ondfrukt/Phone-exchange/README.md

# Phone Exchange - (Under development) # 

## Thanks to! ##

First of all, I want to thank my partner Amanda, who has been som patiant whit me - spending countless hours and weekends by my computer while I, for example, trying to figure out a way to capture pulses from rotary phones, or comforting during mental breakdowns when I was sodering without realizing I was using to low temperatur. If you are reading this - which you might not, since you're probebly so tierd of this project - I just want to say that i love you, and do that even more for standing out with me and my stupid phones.

I would also like to thank two GitHub members from whom I’ve drawn a lot of inspiration.

1. [GadgetReboot](https://github.com/GadgetReboot) with his YouTube videos and repositories about the KS0835F SLIC module and the MT8816 switch matrix, really made this project possible.

3. [Ktownsen](https://github.com/ktownsend-personal/) and his repository [RetroPhone](https://github.com/ktownsend-personal/RetroPhone) showed me that there is someone else out there who thinks an old wired phone network would be cool, and who shares the same passion for making vintage phones work just like they did back in the day. My call process modes and flows are heavily inspired by his work.

## Goal whit the project ##
The project aims to create a local wired phone network that supports both old rotary phones and newer DTMF tone-dialing phones. No intelligence or electronics will be built into the phones themselves; all logic and switching will be handled by the exchange unit. The network will follow a star topology, with two wires leading to each phone.

The goal is for the network to behave just like it did back in the day. Features such as ringing behavior, tones, and call logic will be implemented.

This is a learning project and my personal introduction to programming, Arduino, HTML, and electronics. It might eventually result in nothing more than a pile of electronic scrap and hundreds of non-functional lines of code—but it will definitely provide me with valuable knowledge and a steep learning curve.

### Typical behaviour for all call ###

A typical procedure of the system will be as shown below.
- A hook is lifted, the status of the line changes from "idle" to "ready" and a continuous tone can be heard in the phone hook.
- A phone number is dialed using pulse dialing or DTMF tones, and the digits are captured by the microcontroller.
- Ring pulses are generated to the dialed line and once the hook is picked up, the audio lines are connected between the two lines and the conversation can begin.
- Ones one of the connected phones puts it's handset into the crank, the audio connection between the lines breaks and the call ends.

## Hardware ##
<p align="center">
System Overview
</p>

| Component | Description |
|---|---|
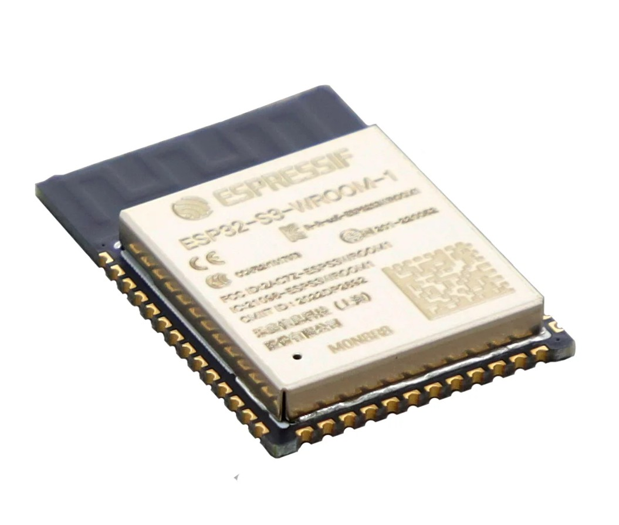
[picture p1: docs/ESP32-S3-WROOM.jpg]
| ESP32-S3<br>  | - I have always appreciated the ESP family of microcontrollers. After first experimenting with Arduino modules such as the Arduino Uno and Arduino Uno WiFi, it quickly became clear that the ESP32 offered significantly more features at a lower cost. <br> - This module includes 8 MB of flash memory — an important improvement, since the 4 MB version ran out of space during earlier POC work. <br> - Like most ESP chips, it also provides both WiFi and Bluetooth, which are used here for the webserver and WiFi provisioning. The ESP32-C6 was initially considered due to its support for Matter and Zigbee. However, at the time it was not supported in PlatformIO, so the more common ESP32-S3 was selected for this project.
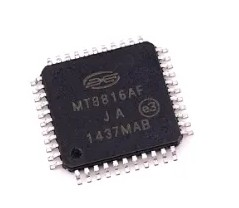
[picture p2: docs/MT8816AF.jpg]
| MT8816<br> | The MT8816 is a crosspoint swich matrix where you can connect one phone lines audio out to a certain lines audio in, and of course also in the opposite direction so a full audio connection is established more about how it works can be found [here](src/services/Readme.md) | 
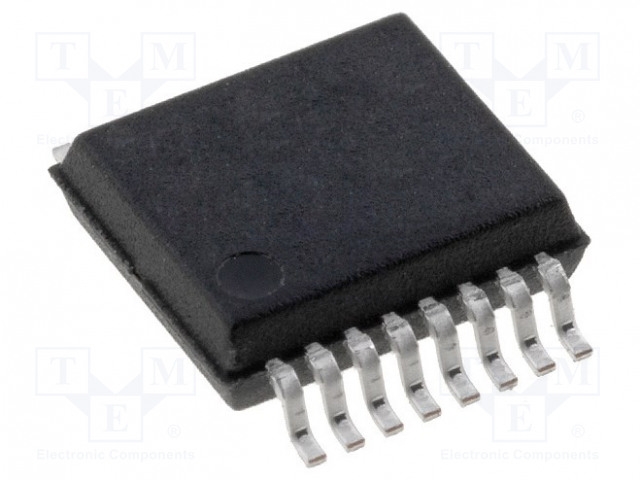
[picture p3: docs/MT8870.jpg]
| MT8870<br> | This circuit translates all tones from DTMF phones into digits. |
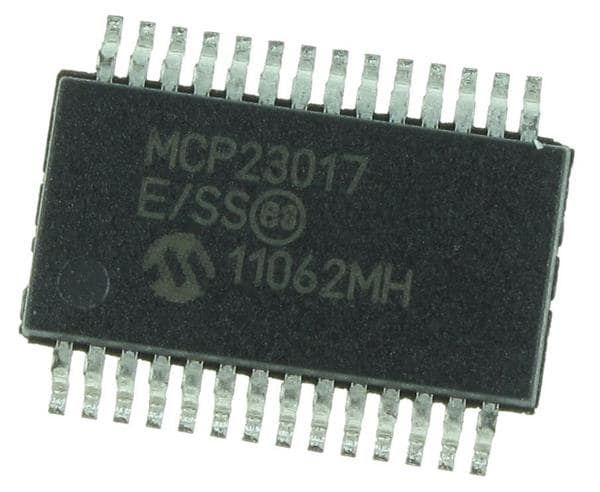
[picture p4: docs/MCP23017.jpg]
| MCP23017 | GPIO expanders because the ESP32 do not have enough GPIO ports to control all devices |
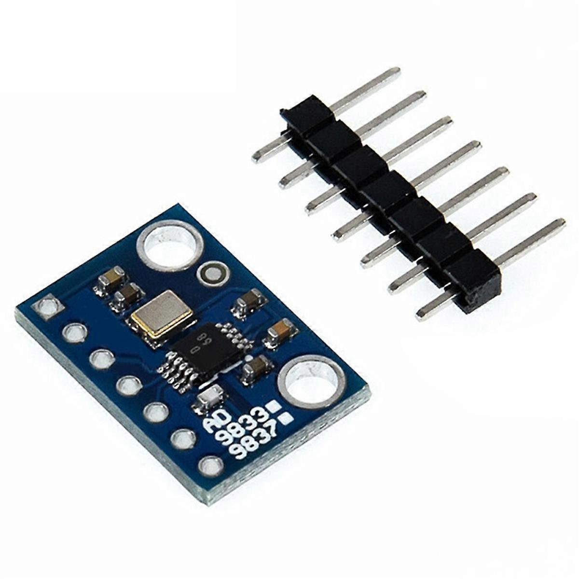
[picture p5: docs/AD9833.jpg]
| AD9833 module | The AD9833 module, which I have three of in the exchange Is sending out tones into the swich matrix and then thuther to lines. |
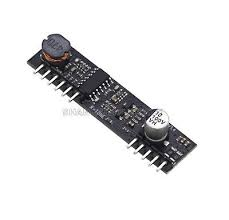
[picture p6: docs/KS0835F.jpg]
| KS0835F<br> | This module may be the most important one on the breadboard. It handles the phone's behavior and converts it into signals that my ESP can process. It detects whether the phone's hook is on or off and can generate a ring frequency, which would otherwise be very complicated to produce. |
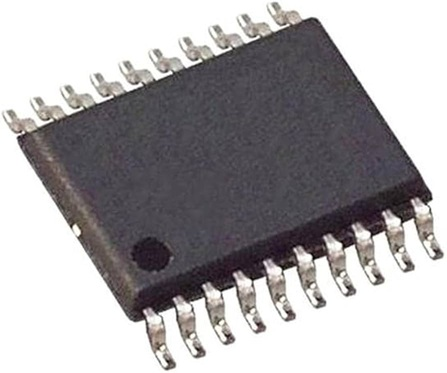
[picture p7: docs/PCM5102.jpg]
| PCM5102<br> | Audio files stored on the ESP are sent to this digital-to-analog converter to output audio messages to the lines when needed. The converter uses I²S communication with the ESP and outputs an analog representation of short, pre-stored audio clips. |
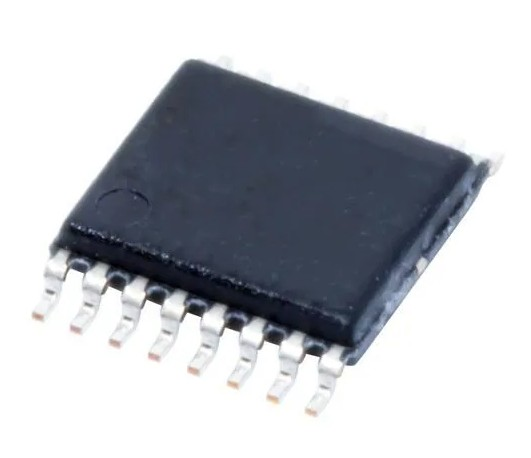
[picture p8: docs/TMUX4051.jpg]
| TMUX4051<br> | This audio multiplexer acts like a large switch, allowing the audio-out channel of each line to be selectively connected to the MT8870 DTMF detector. Only one channel at a time is connected to the DTMF decoder, and the system continuously sweeps through all lines that are in a state where tone detection is required.

In this way, it is possible to determine which line a tone originates from while using only a single DTMF detector.  |

## Webserver ##
I thought it would be good to have an interface where you could manage the phone system in some way, such as assigning a phone number to a specific line, activating/deactivating lines, changing the ring tone length, and adding some more features. During operation, access to the serial monitor will be limited, so having a way to easily tweak settings and access some debugging information would be useful.

The webserver can be reached at http://phoneexchange.local/ after the provisioning is completed

## MQTT ##
Having an MQTT function is also a goal so that the server can potentially interact with a smart home system such as Home Assistant, opening up the possibility to control home functions — just for fun!

## Line Statuses ##

To handle the logics in the exchange system, all lines has a current status whish triggers different logics in the system when they are changed.

### Status table ###
- Hook  :telephone_receiver: - If the phone hook is on or off due to the status
- Timer :stopwatch: - If the new status initiate a timer
- Audio :loud_sound: -  If a audio is played to the line due to the status (might not be implemented)
- Tone :postal_horn: - if a tone is played to the line due to the status

| Phone status  | Function | Hook | Timer | Audio | Tone |
| --- | --- | --- | ----- |---|---|
| idle | Line is not in use | ✅ ON | ❌ | ➖ | ❌ |
| ready | Line is ready, waiting for inputs | ⚪ OFF | ✅ | ➖ | ✅ |
| puls_dialing  | Rotary dialing in progress | ⚪ OFF | ✅ | ➖ | ❌ |
| tone_dialing  | Touch-tone dialing in progress | ⚪ OFF | ✅ | ➖ | ❌ |
| busy | Receiving busy signal | ⚪ OFF | ✅ | ➖ | ✅ |
| fail | Line failed to connect | ⚪ OFF | ✅ | ➖ | ✅ |
| ringing | Line is ringing (outgoing call) | ⚪ OFF | ✅ | ➖ | ✅ |
| connected | Call is active | ⚪ OFF | ❌ | ➖ | ❌ |
| disconnected  | Call has ended, but line not yet idle | ⚪ OFF | ✅ | ➖ | ❌ |
| timeout | Line timed out | ⚪ OFF | ✅ | ➖ | ✅ |
| abandoned | Line was abandoned | ⚪ OFF | ✅ | ➖ | ✅ |
| incoming | Incoming call | ✅ ON | ❌ | ➖ | ❌ |
| operator | Connected to operator | ➖ | ❌ | ➖ | ❌ |

### Status flow chart ###
The flowchart below shows how the statuses change based on the behavior of the phone hooks or when status timers expire. This part is largely inspired by [GadgetReboot](https://github.com/GadgetReboot)
 and his repository “Retro Phone”. Many thanks to him!
 
  <a href="https://raw.githubusercontent.com/ondfrukt/phone-exchange/main/docs/StatusflowChart.drawio.svg">
    Diagram (SVG)
  </a>

## Challenges ##

- **SHK interference during ring signal generation**

The KS0835F SLIC's ring voltage (RM HIGH, FR toggling at 20 Hz) induces false SHK transitions, making it impossible to distinguish interference from a real pick-up. Simply ignoring SHK events during ringing suppresses the noise but also swallows genuine pick-ups — the interrupt is consumed and no new one fires during the pause, so the call never connects.

**Workaround in `SHKService`:** SHK events during `RingToggling` are still suppressed. When a line transitions from `RingToggling` to `RingPause`, the SHK pin is immediately force-polled. The debounce filter then confirms the true state: a real pick-up keeps SHK HIGH and the call connects; interference has already cleared and no change is registered. Maximum detection delay equals one ring-burst length (default 1 s).
