ondfrukt/Phone-exchange/src/util/Readme.md

Här läggs små funktioner som används enstaka tillfälle vid exempelvis uppstart. i2C-scanner exempelvis eller uppstartsmeddelanden.
