ondfrukt/Phone-exchange/docs/Block Diagram Hardware.drawio.png

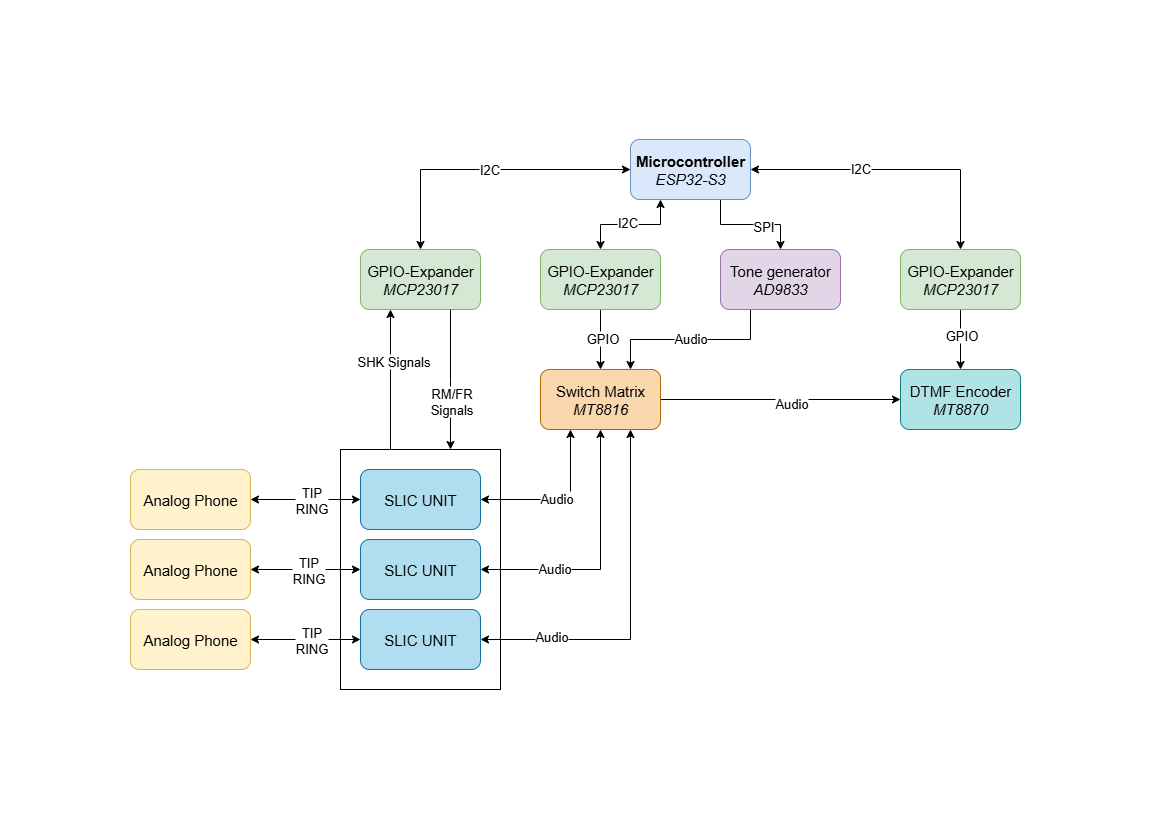
docs/Block Diagram Hardware.drawio.png
