ondfrukt/Phone-exchange/docs/MT8816 Connections.png

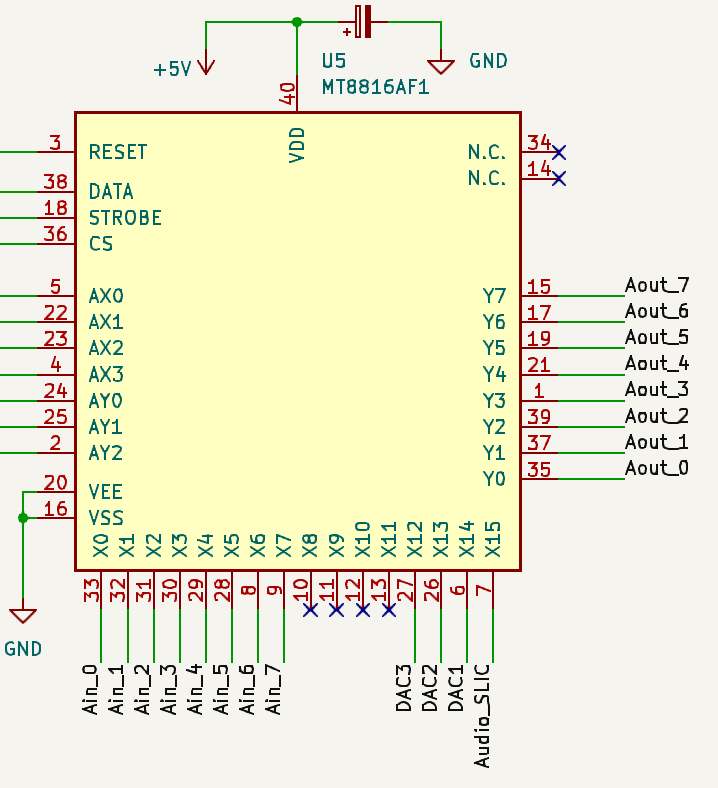
docs/MT8816 Connections.png
