ondfrukt/Phone-exchange/docs/MT8817.jpg

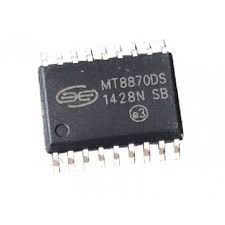
docs/MT8817.jpg
