ondfrukt/Phone-exchange/(threads)

Thread 7 (2025-09-07):

More documentation

QuteNZ, 2025-09-07:
Great to see a phone exchange project and I do like to build one for fun as desktop phones may disappeared because of the prefoliation of mobile device.

A schematics or detailed documentation in PDF format would be great for me to get it started.

Thank you for your generosity for your contribution.

cheers,
Yubing Zhang

ondfrukt, 2025-09-10:
Wow! Never thought that this would be of interest for anyone!
I have kind of worked with this for a long time but speeded the tempo last months to get somewhere. At the moment I'm waiting for my second PCB that will holds all my slic-modules and also finishing sodering my first PCB which holds my ESP and other functions.

Ass soon I have verified that it all works like I hope -  I will upload all schematics and further describe it!
