ondfrukt/Phone-exchange/KiCad/Exchange SLIC-unit V1.3/Exchange SLIC-unit.kicad_pcb

## KiCad design KiCad/Exchange SLIC-unit V1.3/Exchange SLIC-unit.kicad_pcb (2026-10-24)

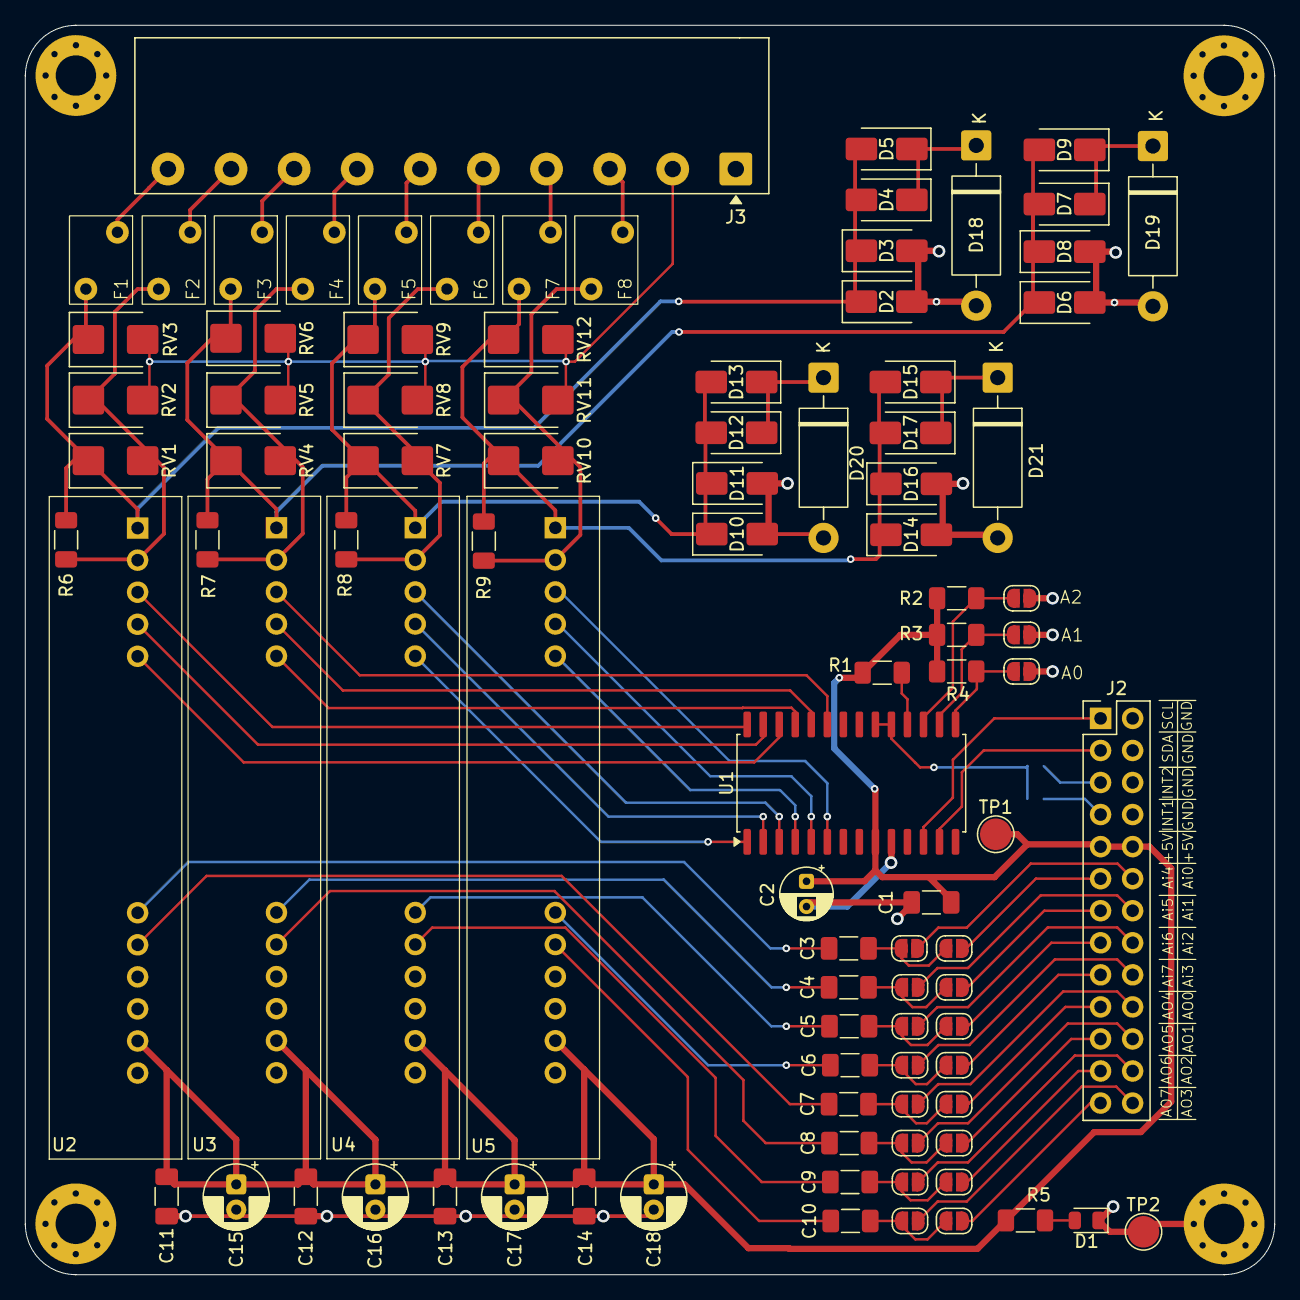
[picture p12: board Exchange SLIC-unit.kicad_pcb from above]

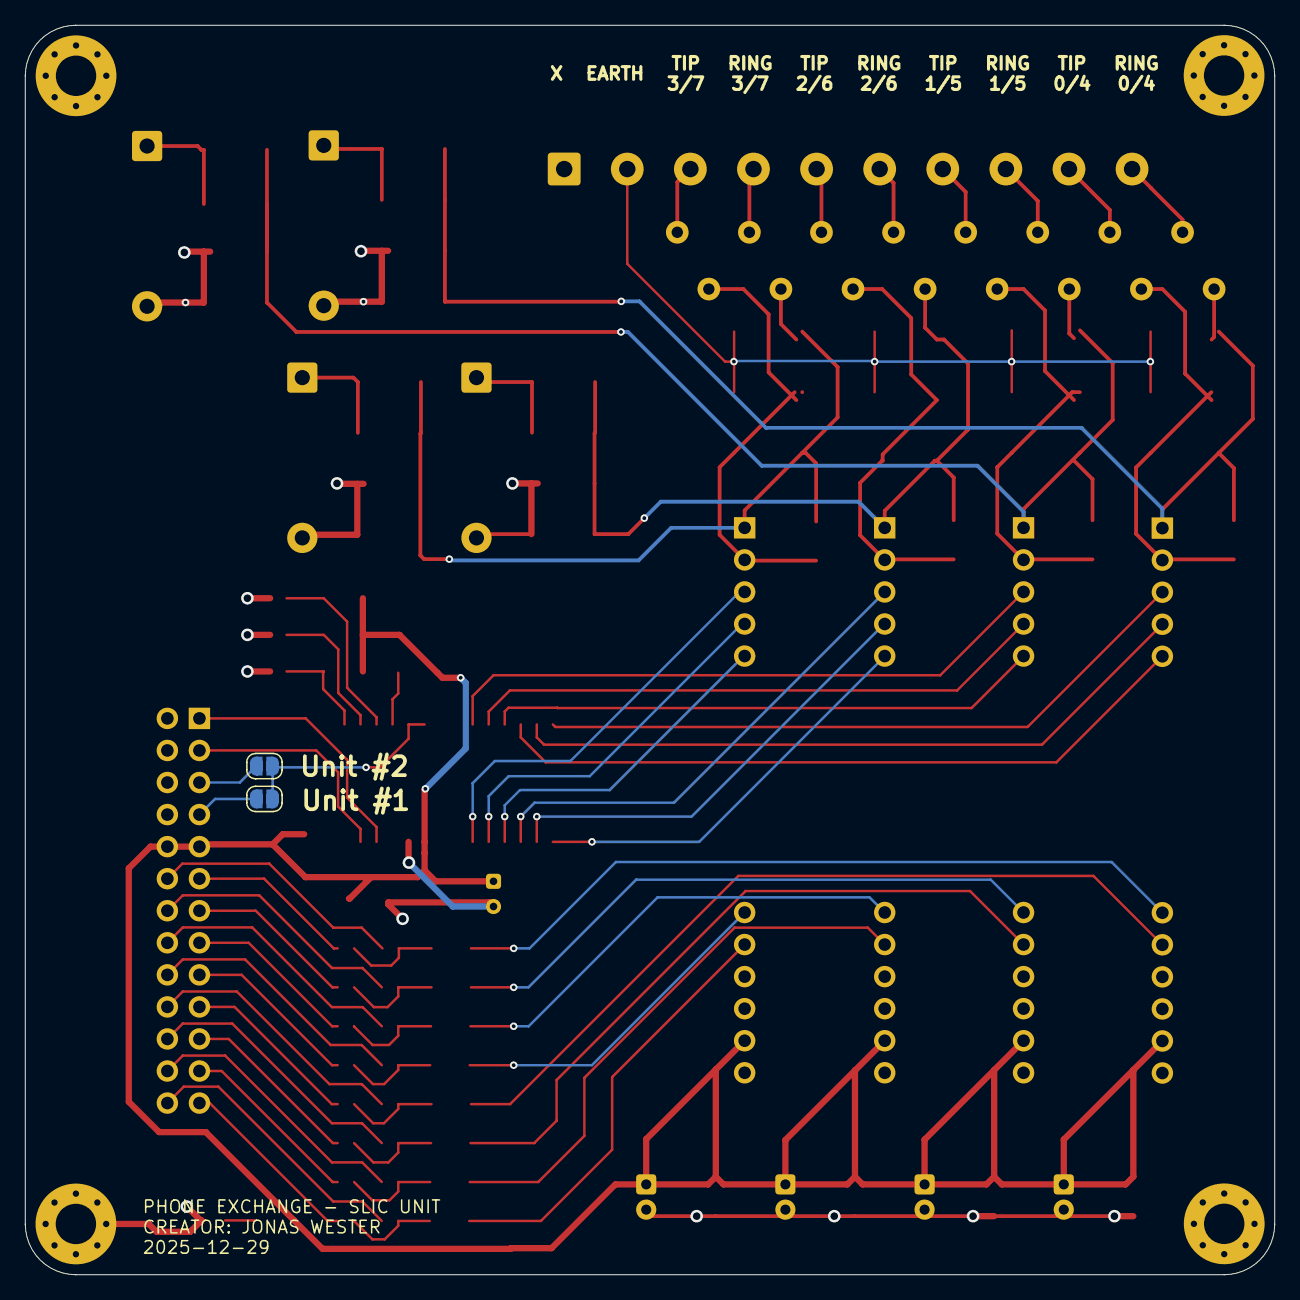
[picture p13: board Exchange SLIC-unit.kicad_pcb from below]

Board: 4 copper layers, 99.0 x 99.0 mm, 102 parts (2 on the bottom side), 77 nets.

Parts:
C1, C3, C4, C5, C6, C7, C8, C9, C10, C11, C12, C13, C14: 0.1uF; C_1206_3216Metric_Pad1.33x1.80mm_HandSolder
C2: 10uF; CP_Radial_D4.0mm_P2.00mm
C15, C16, C17, C18: 10uF; CP_Radial_D5.0mm_P2.00mm
D1: POWER LED; LED_0805_2012Metric
D2, D3, D4, D5, D6, D7, D8, D9, D10, D11, D12, D13, D14, D15, D16, D17: SM4004; D_SMA
D18, D19, D20, D21: P6KE51A; D_DO-15_P12.70mm_Horizontal
F1, F2, F3, F4, F5, F6, F7, F8: MF-R025; Fuse_Polyfuse_BK250_5.08mm_P0.8D1.8
H1, H2, H3, H4: MountingHole_Pad; MountingHole_3.2mm_M3_Pad_Via
J2: Conn_02x13_Odd_Even; PinHeader_2x13_P2.54mm_Vertical
J3: Screw_Terminal_01x10; TerminalBlock_Phoenix_MKDS-1,5-10_1x10_P5.00mm_Horizontal -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
JP1, JP2, JP3, JP4, JP5, JP6, JP7, JP8, JP9, JP10, JP11, JP12, JP13, JP14, JP15, JP16, JP17, JP18, JP19, JP20, JP21: SolderJumper_2_Open; SolderJumper-2_P1.3mm_Open_RoundedPad1.0x1.5mm
R1, R2, R3, R4: 10k; R_1206_3216Metric_Pad1.30x1.75mm_HandSolder
R5: 1k; R_1206_3216Metric_Pad1.30x1.75mm_HandSolder
R6, R7, R8, R9: 1M; R_1206_3216Metric_Pad1.30x1.75mm_HandSolder
RV1, RV2, RV3, RV4, RV5, RV6, RV7, RV8, RV9, RV10, RV11, RV12: Varistor; D_SMB
TP1, TP2: TestPoint; TestPoint_Pad_D2.5mm
U1: MCP23017; SOIC-28W_7.5x17.9mm_P1.27mm
U2, U3, U4, U5: KS0835F

Connections:
+5V: C1.2, C2.1, C11.1, C12.1, C13.1, C14.1, C15.1, C16.1, C17.1, C18.1, J2.9, J2.10, R1.1, R2.1, R3.1, R4.1, R5.1, TP1.1, U1.9 (VDD), U2.10 (+VDC), U3.10 (+VDC), U4.10 (+VDC), U5.10 (+VDC)
/Ain_0/4: C3.2, JP1.1 (A), JP9.2 (B)
/Ain_1/5: C4.2, JP2.1 (A), JP10.2 (B)
/Ain_2/6: C5.2, JP3.1 (A), JP11.2 (B)
/Ain_3/7: C6.2, JP4.1 (A), JP12.2 (B)
/Aout_0/4: C7.2, JP5.1 (A), JP13.2 (B)
/Aout_1/5: C8.2, JP6.1 (A), JP14.2 (B)
/Aout_2/6: C9.2, JP7.1 (A), JP15.2 (B)
/Aout_3/7: C10.2, JP8.1 (A), JP16.2 (B)
/FR_0/4: U1.28 (GPA7), U2.3 (F/R)
/FR_1/5: U1.23 (GPA2), U3.3 (F/R)
/FR_2/6: U1.3 (GPB2), U4.3 (F/R)
/FR_3/7: U1.6 (GPB5), U5.3 (F/R)
/MCP_SLIC_INT_1/2: JP17.1 (A), JP18.1 (A), U1.19 (INTB), U1.20 (INTA)
/RING_0/4: F1.2, J3.10
/RING_1/5: F3.2, J3.8
/RING_2/6: F5.2, J3.6
/RING_3/7: F7.2, J3.4
/RM_0/4: U1.27 (GPA6), U2.4 (RM)
/RM_1/5: U1.24 (GPA3), U3.4 (RM)
/RM_2/6: U1.2 (GPB1), U4.4 (RM)
/RM_3/7: U1.5 (GPB4), U5.4 (RM)
/SCL: J2.1, U1.12 (SCL)
/SDA: J2.3, U1.13 (SDA)
/SHK_0/4: U1.26 (GPA5), U2.5 (SHK)
/SHK_1/5: U1.25 (GPA4), U3.5 (SHK)
/SHK_2/6: U1.1 (GPB0), U4.5 (SHK)
/SHK_3/7: U1.4 (GPB3), U5.5 (SHK)
/TIP_0/4: F2.2, J3.9
/TIP_1/5: F4.2, J3.7
/TIP_2/6: F6.2, J3.5
/TIP_3/7: F8.2, J3.3
GND: C1.1, C2.2, C11.2, C12.2, C13.2, C14.2, C15.2, C16.2, C17.2, C18.2, D1.1 (K), D2.2 (A), D3.2 (A), D6.2 (A), D8.2 (A), D10.2 (A), D11.2 (A), D14.2 (A), D16.2 (A), D18.2, D19.2, D20.2, D21.2, H1.1, H2.1, H3.1, H4.1, J2.2, J2.4, J2.6, J2.8, JP19.2 (B), JP20.1 (A), JP21.1 (A), TP2.1, U1.10 (VSS), U2.9 (GND), U3.9 (GND), U4.9 (GND), U5.9 (GND)
GNDPWR: J3.2, RV2.2, RV3.2, RV5.2, RV6.2, RV8.2, RV9.2, RV11.2, RV12.2
unnamed: D1.2 (A), R5.2
unnamed: D2.1 (K), D3.1 (K), D4.2 (A), D5.2 (A), F1.1, R6.1, RV1.1, RV3.1, U2.1 (RING)
unnamed: D4.1 (K), D5.1 (K), D18.1
unnamed: D6.1 (K), D7.2 (A), D8.1 (K), D9.2 (A), F3.1, R7.1, RV4.1, RV6.1, U3.1 (RING)
unnamed: D7.1 (K), D9.1 (K), D19.1
unnamed: D10.1 (K), D11.1 (K), D12.2 (A), D13.2 (A), F5.1, R8.1, RV7.1, RV9.1, U4.1 (RING)
unnamed: D12.1 (K), D13.1 (K), D20.1
unnamed: D14.1 (K), D15.2 (A), D16.1 (K), D17.2 (A), F7.1, R9.1, RV10.1, RV12.1, U5.1 (RING)
unnamed: D15.1 (K), D17.1 (K), D21.1
unnamed: J2.5, JP18.2 (B)
unnamed: J2.7, JP17.2 (B)
unnamed: J2.11, JP9.1 (A)
unnamed: J2.12, JP1.2 (B)
unnamed: J2.13, JP10.1 (A)
unnamed: J2.14, JP2.2 (B)
unnamed: J2.15, JP11.1 (A)
unnamed: J2.16, JP3.2 (B)
unnamed: J2.17, JP12.1 (A)
unnamed: J2.18, JP4.2 (B)
unnamed: J2.19, JP13.1 (A)
unnamed: J2.20, JP5.2 (B)
unnamed: J2.21, JP14.1 (A)
unnamed: J2.22, JP6.2 (B)
unnamed: J2.23, JP15.1 (A)
unnamed: J2.24, JP7.2 (B)
unnamed: J2.25, JP16.1 (A)
unnamed: J2.26, JP8.2 (B)
unnamed: JP19.1 (A), R2.2, U1.17 (A2)
unnamed: JP20.2 (B), R3.2, U1.16 (A1)
unnamed: JP21.2 (B), R4.2, U1.15 (A0)
unnamed: R1.2, U1.18 (~RESET)
unnamed: C3.1, U2.6 (Audio_in)
unnamed: C7.1, U2.7 (Audio_out)
unnamed: F2.1, R6.2, RV1.2, RV2.1, U2.2 (TIP)
unnamed: C4.1, U3.6 (Audio_in)
unnamed: C8.1, U3.7 (Audio_out)
unnamed: F4.1, R7.2, RV4.2, RV5.1, U3.2 (TIP)
unnamed: C5.1, U4.6 (Audio_in)
unnamed: C9.1, U4.7 (Audio_out)
unnamed: F6.1, R8.2, RV7.2, RV8.1, U4.2 (TIP)
unnamed: C6.1, U5.6 (Audio_in)
unnamed: C10.1, U5.7 (Audio_out)
unnamed: F8.1, R9.2, RV10.2, RV11.1, U5.2 (TIP)
