ondfrukt/Phone-exchange/KiCad/Exchange ESP-unit S3 V1.4/Exchange ESP-unit S3.kicad_pcb

## KiCad design KiCad/Exchange ESP-unit S3 V1.4/Exchange ESP-unit S3.kicad_pcb (2026-10-24)

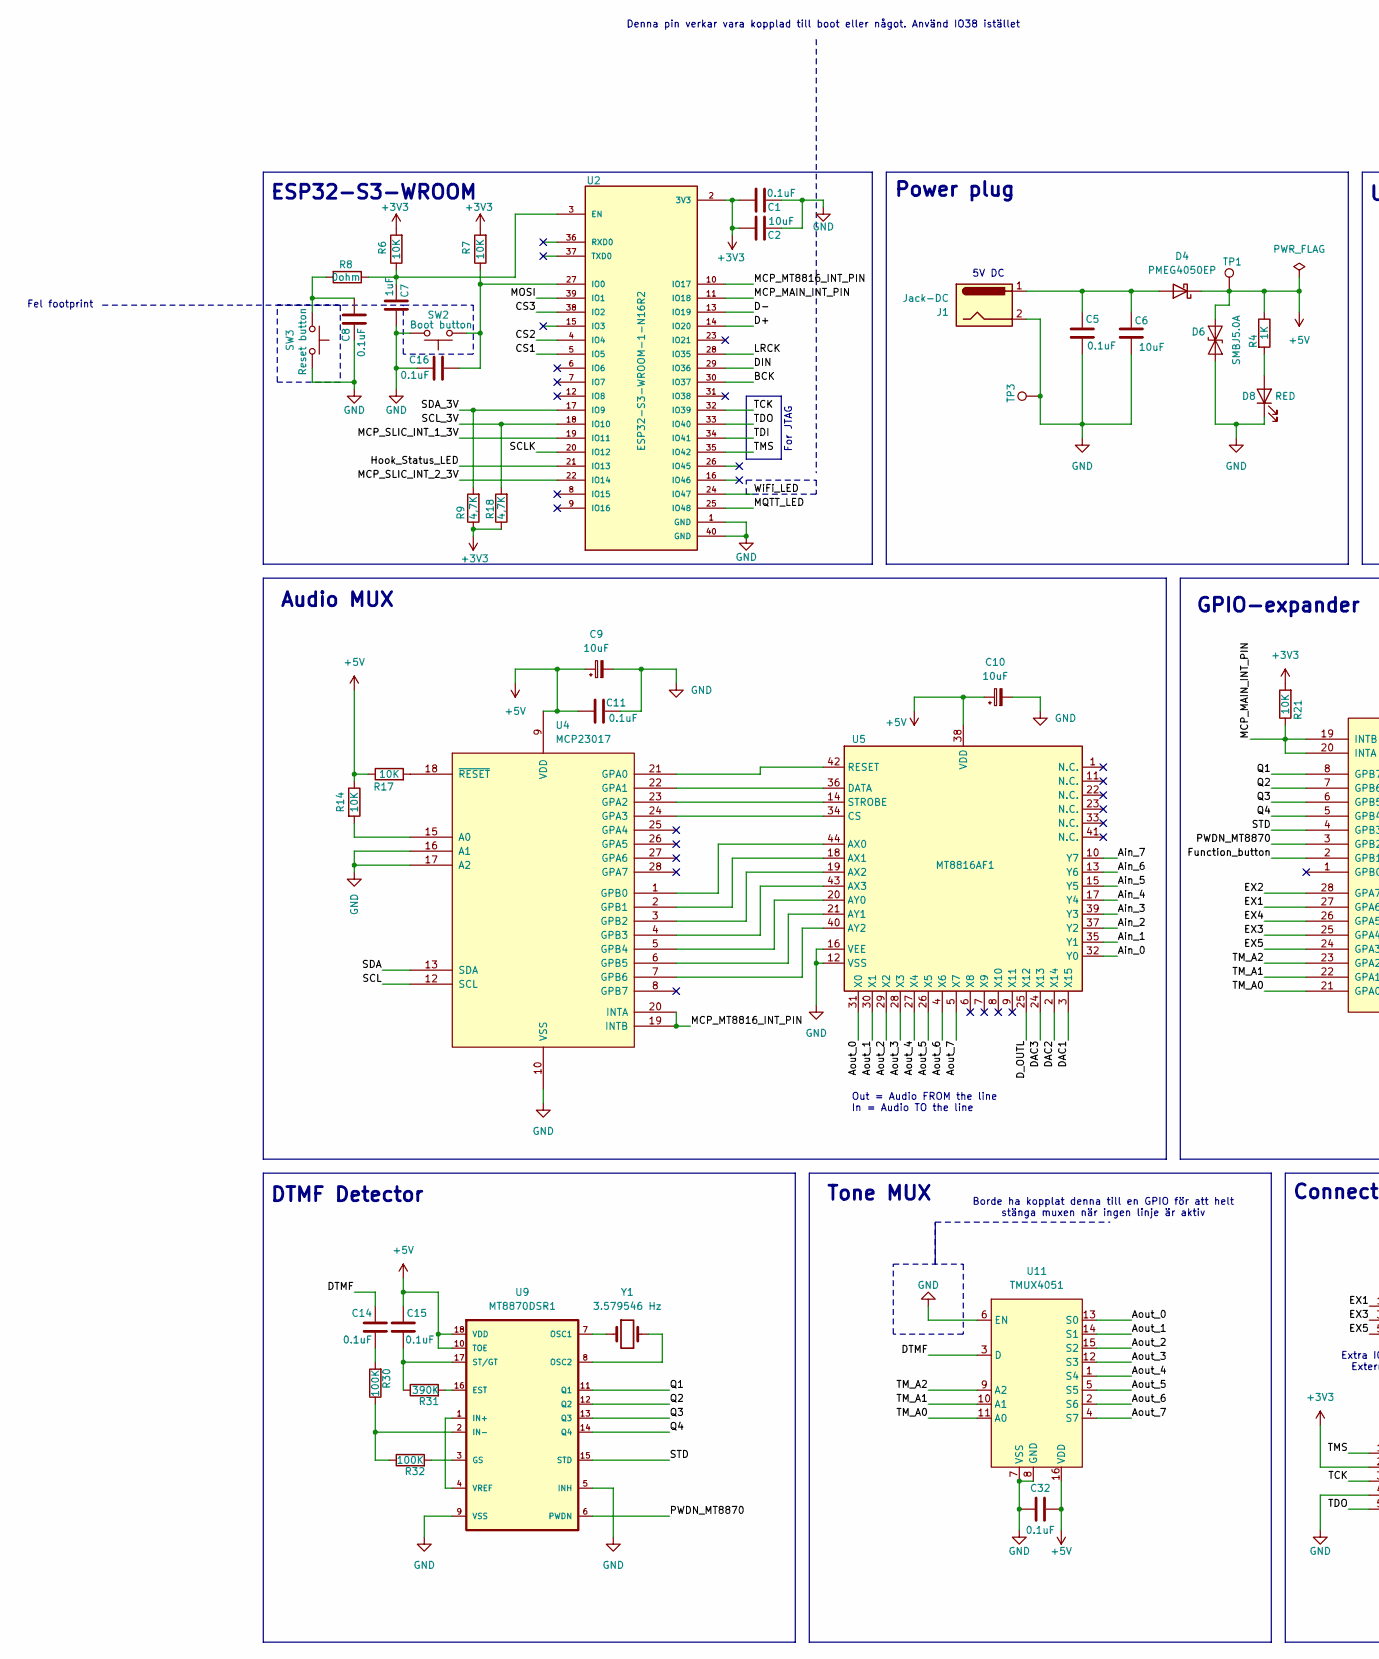
[picture p14: schematic Exchange ESP-unit S3.kicad_sch, Phone exchange - ESP-Unit, part in row 1, column 1]

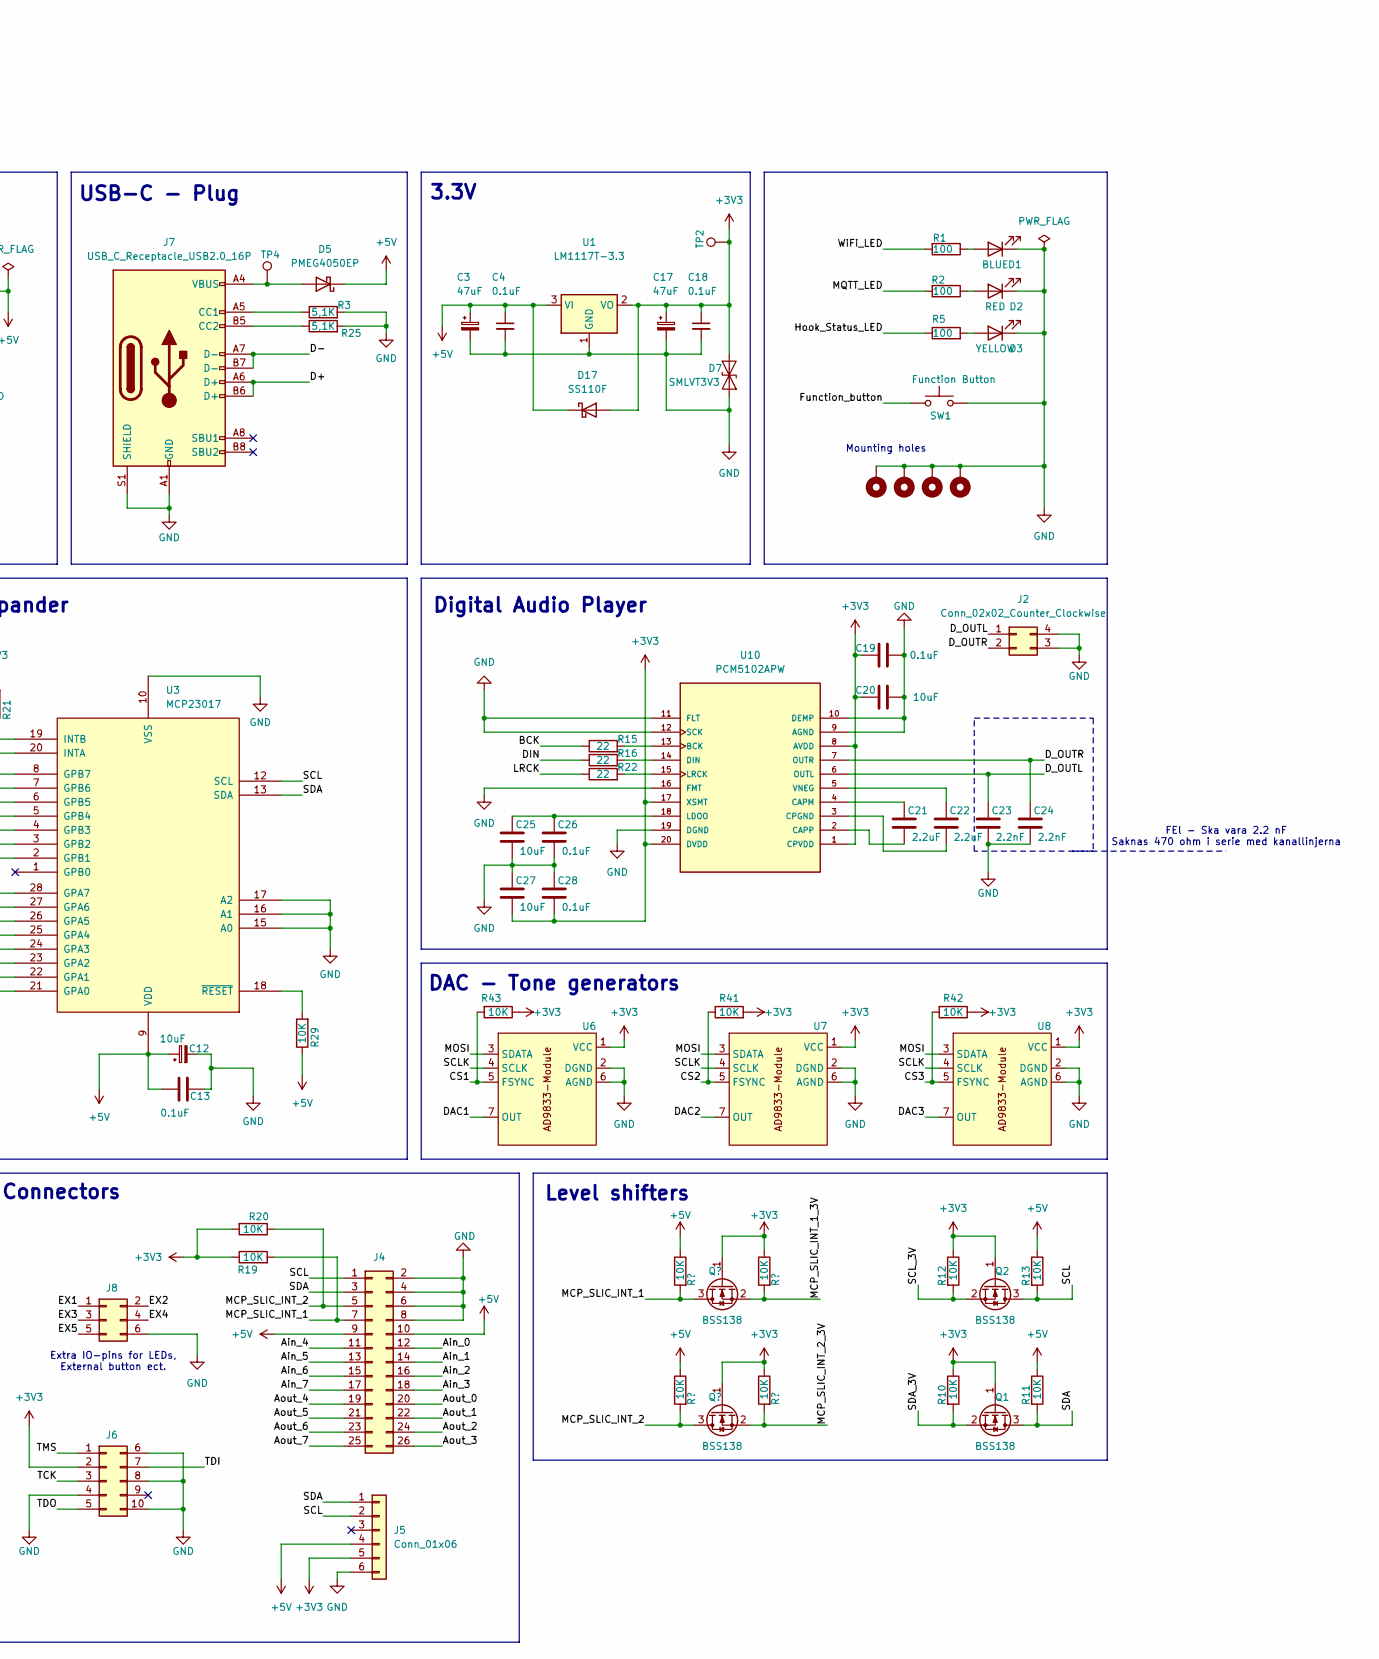
[picture p15: schematic Exchange ESP-unit S3.kicad_sch, Phone exchange - ESP-Unit, part in row 1, column 2]

Parts:
C1, C4, C5, C8, C11, C13, C14, C15, C16, C18, C19, C26, C28, C32: 0.1uF; C_1206_3216Metric_Pad1.33x1.80mm_HandSolder
C2, C6, C20, C25, C27: 10uF; C_1206_3216Metric_Pad1.33x1.80mm_HandSolder
C3, C17: 47uF; CP_Radial_D4.0mm_P2.00mm
C7: 1uF; C_1206_3216Metric_Pad1.33x1.80mm_HandSolder
C9, C10, C12: 10uF; CP_Radial_D4.0mm_P2.00mm
C21, C22: 2.2uF; C_1206_3216Metric_Pad1.33x1.80mm_HandSolder
C23, C24: 2.2nF; C_1206_3216Metric_Pad1.33x1.80mm_HandSolder
D1: BLUE; LED_0805_2012Metric_Pad1.15x1.40mm_HandSolder
D2, D8: RED; LED_0805_2012Metric_Pad1.15x1.40mm_HandSolder
D3: YELLOW; LED_0805_2012Metric_Pad1.15x1.40mm_HandSolder
D4, D5: PMEG4050EP; D_SOD-128
D6: SMBJ5.0A; D_SMB
D7: SMLVT3V3; D_SMB_Handsoldering
D17: SS110F; D_SMA_Handsoldering
H1, H2, H3, H4: MountingHole_Pad; MountingHole_3.2mm_M3_Pad_Via
J1: Jack-DC; BarrelJack_Horizontal
J2: Conn_02x02_Counter_Clockwise; PinHeader_2x02_P2.54mm_Vertical
J4: Conn_02x13_Odd_Even; PinSocket_2x13_P2.54mm_Vertical
J5: Conn_01x06; PinHeader_1x06_P2.54mm_Vertical
J6: Conn_02x05_Top_Bottom; PinSocket_2x05_P2.54mm_Vertical
J7: USB_C_Receptacle_USB2.0_16P; USB_C_Receptacle_GCT_USB4105-xx-A_16P_TopMnt_Horizontal
J8: Conn_02x03_Odd_Even; PinHeader_2x03_P2.54mm_Vertical
Q1, Q2: BSS138; SOT-23
R1, R2, R5: 100; R_1206_3216Metric_Pad1.30x1.75mm_HandSolder
R3, R25: 5,1K; R_1206_3216Metric_Pad1.30x1.75mm_HandSolder
R4: 1K; R_1206_3216Metric_Pad1.30x1.75mm_HandSolder
R6, R7, R10, R11, R12, R13, R14, R17, R19, R20, R21, R29, R41, R42, R43: 10K; R_1206_3216Metric_Pad1.30x1.75mm_HandSolder
R8: 0ohm; R_1206_3216Metric_Pad1.30x1.75mm_HandSolder
R9, R18: 4,7K; R_1206_3216Metric_Pad1.30x1.75mm_HandSolder
R15, R16, R22: 22; R_1206_3216Metric_Pad1.30x1.75mm_HandSolder
R30, R32: 100K; R_1206_3216Metric_Pad1.30x1.75mm_HandSolder
R31: 390K; R_1206_3216Metric_Pad1.30x1.75mm_HandSolder
SW1: Function Button; SW_SPST_TL3305B
SW2: Boot button; SW_SPST_TL3305B
SW3: Reset button; SW_SPST_TL3305B
TP1, TP2, TP3, TP4: TestPoint; TestPoint_Pad_D2.0mm
U1: LM1117T-3.3; TO-220-3_Vertical
U2: ESP32-S3-WROOM-1-N16R2; XCVR_ESP32-S3-WROOM-1-N16; PARTREV v1.0
U3, U4: MCP23017; SOIC-28W_7.5x17.9mm_P1.27mm
U5: MT8816AF1; TQFP-44_10x10mm_P0.8mm
U6, U7, U8: AD9833-module; AD9833-Module
U9: MT8870DSR1; SOIC-18W_7.5x11.6mm_P1.27mm
U10: PCM5102APW; TSSOP-20_4.4x6.5mm_P0.65mm; PARTREV C
U11: TMUX4051; TSSOP-16_4.4x5mm_P0.65mm
Y1: 3.579546 Hz; Crystal_HC49-4H_Vertical

Connections:
+5V: C3.1, C4.1, C9.1, C10.1, C11.1, C12.1, C13.2, C15.1, C32.2, D4.1 (K), D5.1 (K), D6.1 (A1), D17.1 (K), J4.9, J4.10, J5.4, R4.1, R11.1, R13.1, R14.1, R17.1, R29.1, TP1.1, U1.3 (VI), U3.9 (VDD), U4.9 (VDD), U5.38 (VDD), U9.10 (TOE), U9.18 (VDD), U11.16 (VDD)
/Ain_0: J4.12, U5.32 (Y0)
/Ain_1: J4.14, U5.35 (Y1)
/Ain_2: J4.16, U5.37 (Y2)
/Ain_3: J4.18, U5.39 (Y3)
/Ain_4: J4.11, U5.17 (Y4)
/Ain_5: J4.13, U5.15 (Y5)
/Ain_6: J4.15, U5.13 (Y6)
/Ain_7: J4.17, U5.10 (Y7)
/Aout_0: J4.20, U5.31 (X0), U11.13 (S0)
/Aout_1: J4.22, U5.30 (X1), U11.14 (S1)
/Aout_2: J4.24, U5.29 (X2), U11.15 (S2)
/Aout_3: J4.26, U5.28 (X3), U11.12 (S3)
/Aout_4: J4.19, U5.27 (X4), U11.1 (S4)
/Aout_5: J4.21, U5.26 (X5), U11.5 (S5)
/Aout_6: J4.23, U5.4 (X6), U11.2 (S6)
/Aout_7: J4.25, U5.5 (X7), U11.4 (S7)
/BCK: R15.1, U2.30 (IO37)
/CS1: R43.2, U2.5 (IO5), U6.5 (FSYNC)
/CS2: R41.1, U2.4 (IO4), U7.5 (FSYNC)
/CS3: R42.2, U2.38 (IO2), U8.5 (FSYNC)
/D+: J7.A6 (D+), J7.B6 (D+), U2.14 (IO20)
/D-: J7.A7 (D-), J7.B7 (D-), U2.13 (IO19)
/DAC1: U5.3 (X15), U6.7 (OUT)
/DAC2: U5.2 (X14), U7.7 (OUT)
/DAC3: U5.24 (X13), U8.7 (OUT)
/DIN: R16.1, U2.29 (IO36)
/DTMF: C14.2, U11.3 (D)
/D_OUTL: C23.1, J2.1, U5.25 (X12), U10.6 (OUTL)
/D_OUTR: C24.1, J2.2, U10.7 (OUTR)
/EX1: J8.1, U3.27 (GPA6)
/EX2: J8.2, U3.28 (GPA7)
/EX3: J8.3, U3.25 (GPA4)
/EX4: J8.4, U3.26 (GPA5)
/EX5: J8.5, U3.24 (GPA3)
/Function_button: SW1.2, U3.2 (GPB1)
/Hook_Status_LED: R5.1, U2.21 (IO13)
/LRCK: R22.1, U2.28 (IO35)
/MCP_MAIN_INT_PIN: R21.1, U2.11 (IO18), U3.19 (INTB), U3.20 (INTA)
/MCP_MT8816_INT_PIN: U2.10 (IO17), U4.19 (INTB), U4.20 (INTA)
/MOSI: U2.39 (IO1), U6.3 (SDATA), U7.3 (SDATA), U8.3 (SDATA)
/MQTT_LED: R2.2, U2.25 (IO48)
/PWDN_MT8870: U3.3 (GPB2), U9.6 (PWDN)
/Q1: U3.8 (GPB7), U9.11 (Q1)
/Q2: U3.7 (GPB6), U9.12 (Q2)
/Q3: U3.6 (GPB5), U9.13 (Q3)
/Q4: U3.5 (GPB4), U9.14 (Q4)
/SCL: J4.1, J5.2, Q2.3 (D), R13.2, U3.12 (SCL), U4.12 (SCL)
/SCLK: U2.20 (IO12), U6.4 (SCLK), U7.4 (SCLK), U8.4 (SCLK)
/SCL_3V: Q2.2 (S), R12.2, R18.2, U2.18 (IO10)
/SDA: J4.3, J5.1, Q1.3 (D), R11.2, U3.13 (SDA), U4.13 (SDA)
/SDA_3V: Q1.2 (S), R9.2, R10.2, U2.17 (IO9)
/STD: U3.4 (GPB3), U9.15 (STD)
/TCK: J6.3, U2.32 (IO39)
/TDI: J6.7, U2.34 (IO41)
/TDO: J6.5, U2.33 (IO40)
/TMS: J6.1, U2.35 (IO42)
/TM_A0: U3.21 (GPA0), U11.11 (A0)
/TM_A1: U3.22 (GPA1), U11.10 (A1)
/TM_A2: U3.23 (GPA2), U11.9 (A2)
/WiFi_LED: R1.2, U2.24 (IO47)
GND: C1.1, C2.1, C3.2, C4.2, C5.2, C6.2, C7.2, C8.1, C9.2, C10.2, C11.2, C12.2, C13.1, C16.1, C17.2, C18.2, C19.2, C20.2, C23.2, C24.2, C25.2, C26.2, C27.1, C28.1, C32.1, D1.1 (K), D2.1 (K), D3.1 (K), D6.2 (A2), D7.2 (A2), D8.1 (K), H1.1, H2.1, H3.1, H4.1, J1.2, J2.3, J2.4, J4.2, J4.4, J4.6, J4.8, J5.6, J6.4, J6.6, J6.8, J6.10, J7.A1 (GND), J7.A12 (GND), J7.B1 (GND), J7.B12 (GND), J7.S1 (SHIELD), J8.6, R3.2, R25.2, SW1.1, SW2.2, SW3.2, TP3.1, U1.1 (GND), U2.1 (GND), U2.40 (GND), U3.10 (VSS), U3.15 (A0), U3.16 (A1), U3.17 (A2), U4.10 (VSS), U4.16 (A1), U4.17 (A2), U5.12 (VSS), U5.16 (VEE), U6.2 (DGND), U6.6 (AGND), U7.2 (DGND), U7.6 (AGND), U8.2 (DGND), U8.6 (AGND), U9.5 (INH), U9.9 (VSS), U10.9 (AGND), U10.10 (DEMP), U10.11 (FLT), U10.12 (SCK), U10.16 (FMT), U10.19 (DGND), U11.6 (EN), U11.7 (VSS), U11.8 (GND)
unnamed: C8.2, R8.2, SW3.1
unnamed: C14.1, R30.2
unnamed: D1.2 (A), R1.1
unnamed: D2.2 (A), R2.1
unnamed: D3.2 (A), R5.2
unnamed: C5.1, C6.1, D4.2 (A), J1.1
unnamed: D5.2 (A), J7.A4 (VBUS), J7.A9 (VBUS), J7.B4 (VBUS), J7.B9 (VBUS), TP4.1
unnamed: D8.2 (A), R4.2
unnamed: J7.A5 (CC1), R3.1
unnamed: J7.B5 (CC2), R25.1
unnamed: C7.1, R6.1, R8.1, U2.3 (EN)
unnamed: C16.2, R7.1, SW2.1, U2.27 (IO0)
unnamed: R29.2, U3.18 (~RESET)
unnamed: R14.2, U4.15 (A0)
unnamed: U4.21 (GPA0), U5.42 (RESET)
unnamed: U4.22 (GPA1), U5.36 (DATA)
unnamed: U4.23 (GPA2), U5.14 (STROBE)
unnamed: U4.24 (GPA3), U5.34 (CS)
unnamed: U4.1 (GPB0), U5.44 (AX0)
unnamed: U4.2 (GPB1), U5.18 (AX1)
unnamed: U4.3 (GPB2), U5.19 (AX2)
unnamed: U4.4 (GPB3), U5.43 (AX3)
unnamed: U4.5 (GPB4), U5.20 (AY0)
unnamed: U4.6 (GPB5), U5.21 (AY1)
unnamed: U4.7 (GPB6), U5.40 (AY2)
unnamed: R17.2, U4.18 (~RESET)
unnamed: R31.2, U9.16 (EST)
unnamed: R32.2, U9.3 (GS)
unnamed: U9.1 (IN+), U9.4 (VREF)
unnamed: R30.1, R32.1, U9.2 (IN-)
unnamed: U9.7 (OSC1), Y1.1
unnamed: U9.8 (OSC2), Y1.2
unnamed: C15.2, R31.1, U9.17 (ST/GT)
unnamed: R15.2, U10.13 (BCK)
unnamed: C21.1, U10.4 (CAPM)
unnamed: C21.2, U10.2 (CAPP)
unnamed: C22.2, U10.3 (CPGND)
unnamed: R16.2, U10.14 (DIN)
unnamed: C25.1, C26.1, U10.18 (LDOO)
unnamed: R22.2, U10.15 (LRCK)
unnamed: C22.1, U10.5 (VNEG)

Notes on the sheet:
Audio MUX
Fel footprint
ESP32-S3-WROOM
GPIO-expander
DTMF Detector
3.3V
DAC - Tone generators
Extra IO-pins for LEDs, External button ect.
Digital Audio Player
Denna pin verkar vara kopplad till boot eller något. Använd IO38 istället
Power plug
Mounting holes
Tone MUX
For JTAG
Connectors
FEl - Ska vara 2.2 nF Saknas 470 ohm i serie med kanallinjerna
USB-C - Plug
5V DC
Out = Audio FROM the line In = Audio TO the line
Level shifters
Borde ha kopplat denna till en GPIO för att helt stänga muxen när ingen linje är aktiv

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
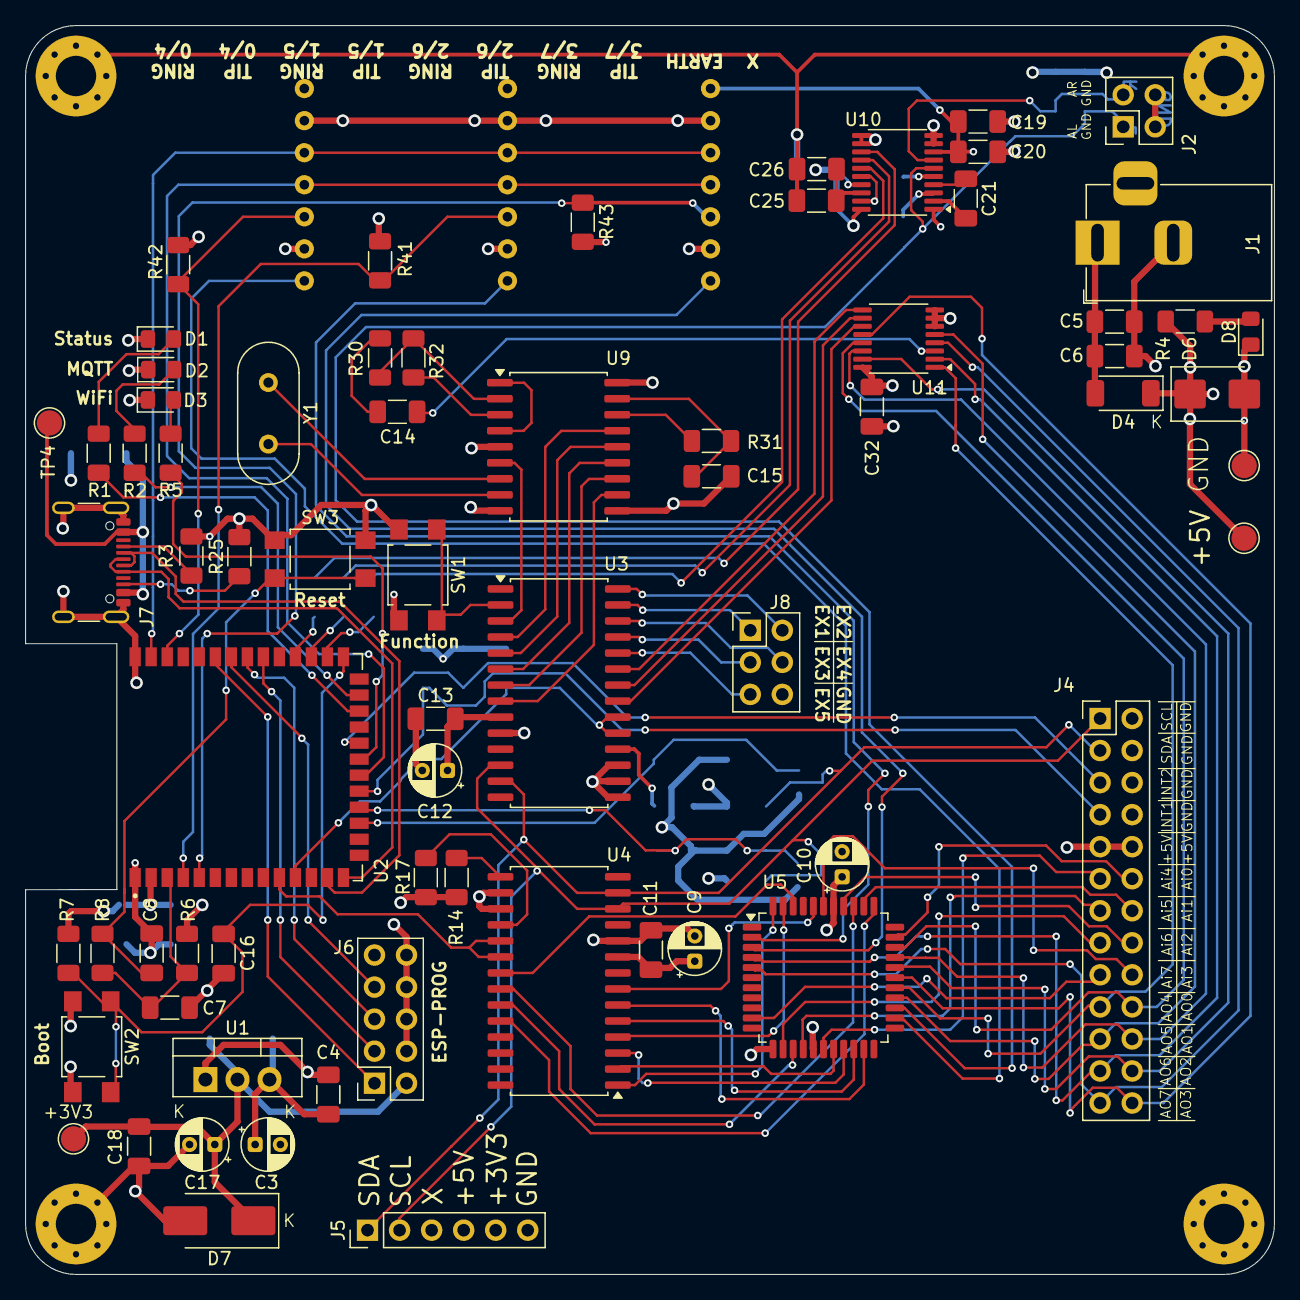
[picture p16: board Exchange ESP-unit S3.kicad_pcb from above]

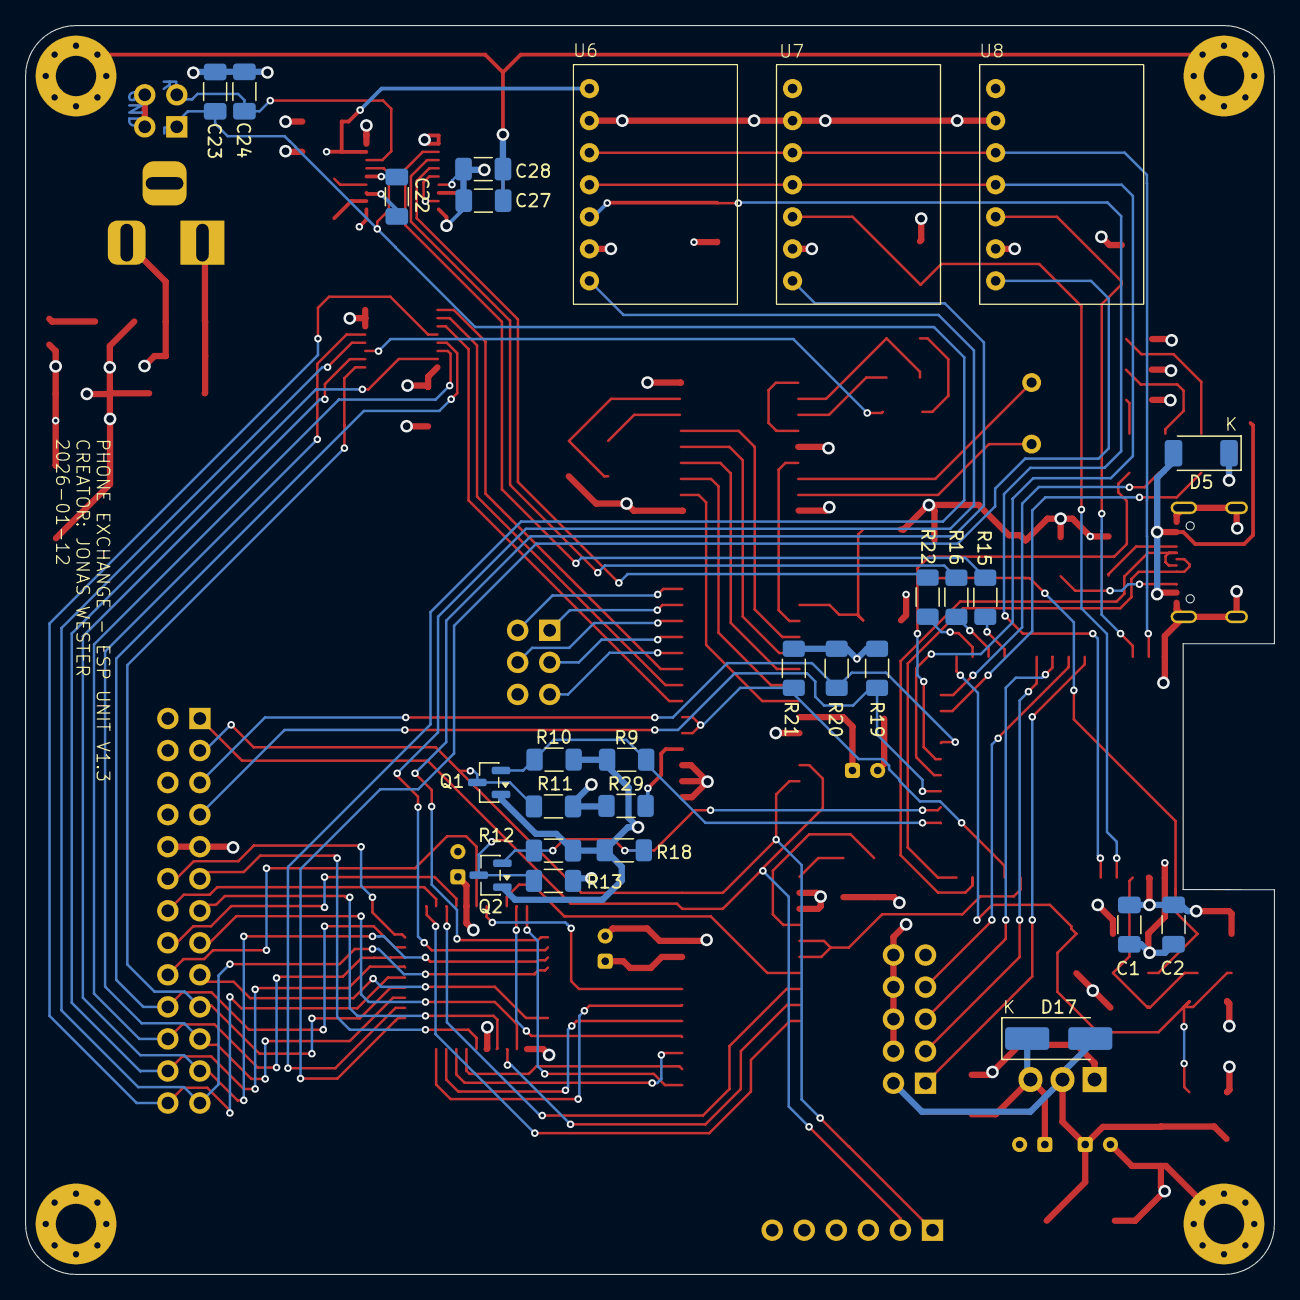
[picture p17: board Exchange ESP-unit S3.kicad_pcb from below]

Board: 4 copper layers, 99.0 x 99.0 mm, 100 parts (27 on the bottom side), 106 nets.
