ondfrukt/Phone-exchange/include/config.h

#pragma once
#include <cstdint>
#include <Arduino.h>

// Console color codes
#define COLOR_RESET "\x1b[0m"
#define RED         "\x1b[31m"
#define GREEN       "\x1b[32m"
#define YELLOW      "\x1b[33m"
#define BLUE        "\x1b[34m"
#define MAGENTA     "\x1b[35m"
#define CYAN        "\x1b[36m"
#define WHITE       "\x1b[37m"

// Bold text
#define BOLD    "\033[1m"

namespace cfg {
  
  namespace ESP_PINS {
    
    // LED pins on the ESP32
    constexpr int Status_LED_PIN = 13;
    constexpr int WiFi_LED_PIN = 47;
    constexpr int MQTT_LED_PIN= 48;

    // AD9833 pins (SPI)
    constexpr int CS1_PIN= 5;
    constexpr int CS2_PIN = 4;
    constexpr int CS3_PIN = 2;
    constexpr int SCLK_PIN = 12;
    constexpr int MOSI_PIN = 1;

    // I2C pins
    constexpr int SDA_PIN= 9;
    constexpr int SCL_PIN= 10;

    // I2S pins for audio output (PCM5102APW)
    inline constexpr int LRCK = 35;
    inline constexpr int DIN = 36;
    inline constexpr int BCK = 37;

  }

  namespace mcp {
    inline constexpr int MCP_MT8816_INT_PIN = 17;
    inline constexpr int MCP_MAIN_INT_PIN = 18;
    inline constexpr int MCP_SLIC_INT_1_PIN = 11;
    inline constexpr int MCP_SLIC_INT_2_PIN = 14;

    inline constexpr uint8_t MCP_MAIN_ADDRESS = 0x20;   //A0=GND, A1=GND, A2=GND
    inline constexpr uint8_t MCP_MT8816_ADDRESS = 0x21; //A0=VCC, A1=GND, A2=GND
    inline constexpr uint8_t MCP_SLIC1_ADDRESS = 0x22;  //A0=GND, A1=VCC, A2=VCC??
    inline constexpr uint8_t MCP_SLIC2_ADDRESS = 0x23;  //A0=GND, A1=VCC, A2=VCC??

    // MCP MAIN
    constexpr uint8_t Q1 = 15;
    constexpr uint8_t Q2 = 14;
    constexpr uint8_t Q3 = 13;
    constexpr uint8_t Q4 = 12;
    constexpr uint8_t STD = 11;
    constexpr uint8_t PWDN_MT8870 = 10;
    constexpr uint8_t FUNCTION_BUTTON = 9;
    constexpr uint8_t EX2 = 7;
    constexpr uint8_t EX1 = 6;
    constexpr uint8_t EX4 = 5;
    constexpr uint8_t EX3 = 4;
    constexpr uint8_t EX5 = 3;
    constexpr uint8_t TM_A2 = 2;
    constexpr uint8_t TM_A1 = 1;
    constexpr uint8_t TM_A0 = 0;

    struct PinModeEntry {
    uint8_t mode;   // INPUT, OUTPUT, INPUT_PULLUP
    bool    initial; // gäller bara om OUTPUT
    };

    constexpr PinModeEntry MCP_MAIN[16] = {
      /*0*/  {OUTPUT, LOW},   // GPA0  TM_A0
      /*1*/  {OUTPUT, LOW},   // GPA1  TM_A1
      /*2*/  {OUTPUT, LOW},   // GPA2  TM_A2
      /*3*/  {OUTPUT, LOW},   // GPA3  EX5
      /*4*/  {OUTPUT, LOW},   // GPA4  EX3
      /*5*/  {OUTPUT, LOW},   // GPA5  EX4
      /*6*/  {OUTPUT, LOW},   // GPA6  EX1
      /*7*/  {OUTPUT, LOW},   // GPA7  EX2
      /*8*/  {OUTPUT, LOW},   // GPB0  Not in use
      /*9*/  {INPUT_PULLUP,0},// GPB1  Test_button (aktiv låg mot GND)
      /*10*/ {OUTPUT, LOW},   // GPB2  PWDN_MT8870 (justera nivå vid behov)
      /*11*/ {INPUT, 0},      // GPB3  STD (status från MT8870)
      /*12*/ {INPUT, 0},      // GPB4  Q4 (MT8870) (pin 5)
      /*13*/ {INPUT, 0},      // GPB5  Q3 (MT8870) (pin 6)
      /*14*/ {INPUT, 0},      // GPB6  Q2 (MT8870) (pin 7)
      /*15*/ {INPUT, 0},      // GPB7  Q1 (MT8870) (pin 8)
    };

    // MCP MT8816
    constexpr uint8_t RESET = 0;    // GPA0
    constexpr uint8_t DATA = 1;     // GPA1
    constexpr uint8_t STROBE = 2;   // GPA2
    constexpr uint8_t CS = 3;       // GPA3

    constexpr uint8_t AX0 = 8;      // GPB0
    constexpr uint8_t AX1 = 9;      // GPB1
    constexpr uint8_t AX2 = 10;     // GPB2
    constexpr uint8_t AX3 = 11;     // GPB3
    constexpr uint8_t AY0 = 12;     // GPB4
    constexpr uint8_t AY1 = 13;     // GPB5
    constexpr uint8_t AY2 = 14;     // GPB6


    constexpr PinModeEntry MCP_MT8816[16] = {
      /*0*/  {OUTPUT, LOW},  // GPA0 -> RESET (MT8816)
      /*1*/  {OUTPUT, LOW},  // GPA1 -> DATA
      /*2*/  {OUTPUT, LOW},  // GPA2 -> STROBE
      /*3*/  {OUTPUT, LOW},  // GPA3 -> CS

      /*4*/  {OUTPUT, LOW},  // GPB0 -> Not in use
      /*5*/  {OUTPUT, LOW},  // GPB1 -> Not in use
      /*6*/  {OUTPUT, LOW},  // GPB2 -> Not in use
      /*7*/  {OUTPUT, LOW},  // GPB3 -> Not in use
      
      /*8*/  {OUTPUT, LOW},  // GPB0 -> AX0
      /*9*/  {OUTPUT, LOW},  // GPB1 -> AX1
      /*10*/ {OUTPUT, LOW},  // GPB2 -> AX2
      /*11*/ {OUTPUT, LOW},  // GPB3 -> AX3
      /*12*/ {OUTPUT, LOW},  // GPB4 -> AY0
      /*13*/ {OUTPUT, LOW},  // GPB5 -> AY1
      /*14*/ {OUTPUT, LOW},  // GPB6 -> AY2

      /*15*/ {OUTPUT, LOW},  // GPB7 -> Not in use
    };

    // MCP SLIC

    constexpr uint8_t SHK_04 = 5;   // GPA5
    constexpr uint8_t SHK_15 = 4;   // GPA4
    constexpr uint8_t SHK_26 = 8;   // GPB0
    constexpr uint8_t SHK_37 = 11;  // GPB3

    constexpr uint8_t RM_04 = 6;    // GPA6
    constexpr uint8_t RM_15 = 3;    // GPA3
    constexpr uint8_t RM_26 = 9;    // GPB1
    constexpr uint8_t RM_37 = 12;   // GPB4

    constexpr uint8_t FR_04 = 7;    // GPA7
    constexpr uint8_t FR_15 = 2;    // GPA2
    constexpr uint8_t FR_26 = 10;   // GPB2    
    constexpr uint8_t FR_37 = 13;   // GPB5

    constexpr uint8_t PD_04 = 0;    // GPA0
    constexpr uint8_t PD_15 = 1;    // GPA1
    constexpr uint8_t PD_26 = 14;   // GPB6
    constexpr uint8_t PD_37 = 15;   // GPB7

    constexpr PinModeEntry MCP_SLIC[16] = {
      /*0*/ {OUTPUT,  LOW},     // GPA0 PD_0/4
      /*1*/ {INPUT,   LOW},     // GPA1 PD_1/5
      /*2*/ {OUTPUT,  LOW},     // GPA2 FR_1/5
      /*3*/ {OUTPUT,  LOW},     // GPA3 RM 1/5
      /*4*/ {INPUT,   LOW},     // GPA4 SHK 1/5 
      /*5*/ {INPUT,   LOW},     // GPA5 SHK 0/4
      /*6*/ {OUTPUT,  LOW},     // GPA6 RM 0/4
      /*7*/ {OUTPUT,  LOW},     // GPA7 FR 0/4 
      /*8*/ {INPUT,   LOW},     // GPB0 SHK 2/6
      /*9*/ {OUTPUT,  LOW},     // GPB1 RM 2/6
      /*10*/{OUTPUT,  LOW},     // GPB2 FR 2/6
      /*11*/{INPUT,   LOW},     // GPB3 SHK 3/7 
      /*12*/{OUTPUT,  LOW},     // GPB4 RM 3/7
      /*13*/{OUTPUT,  LOW},     // GPB5 FR 3/7  
      /*14*/{INPUT,   LOW},     // GPB6 PD_2/6
      /*15*/{INPUT,   LOW},     // GPB7 PD_3/7
    };

    inline constexpr uint8_t SHK_LINE_ADDR[8] = {
      MCP_SLIC1_ADDRESS, MCP_SLIC1_ADDRESS, MCP_SLIC1_ADDRESS, MCP_SLIC1_ADDRESS,
      MCP_SLIC2_ADDRESS, MCP_SLIC2_ADDRESS, MCP_SLIC2_ADDRESS, MCP_SLIC2_ADDRESS
    };

    inline constexpr std::size_t SHK_LINE_COUNT = 8;
    inline constexpr std::size_t FR_LINE_COUNT = 8;
    inline constexpr std::size_t RM_LINE_COUNT = 8;

    constexpr uint8_t SHK_PINS[8] = {
      SHK_04,   // Line 0 MCP_SLIC1, GPA5
      SHK_15,   // Line 1 MCP_SLIC1, GPA4
      SHK_26,   // Line 2 MCP_SLIC1, GPB0
      SHK_37,   // Line 3 MCP_SLIC1, GPB3
      SHK_04,   // Line 4 MCP_SLIC2, GPA5
      SHK_15,   // Line 5 MCP_SLIC2, GPA4
      SHK_26,   // Line 6 MCP_SLIC2, GPB0
      SHK_37,   // Line 7 MCP_SLIC2, GPB3
    };
    constexpr uint8_t FR_PINS[8] = {
      FR_04,   // Line 0 MCP_SLIC1, GPA7
      FR_15,   // Line 1 MCP_SLIC1, GPA2
      FR_26,   // Line 2 MCP_SLIC1, GPB2
      FR_37,   // Line 3 MCP_SLIC1, GPB5
      FR_04,   // Line 4 MCP_SLIC2, GPA7
      FR_15,   // Line 5 MCP_SLIC2, GPA2
      FR_26,   // Line 6 MCP_SLIC2, GPB2
      FR_37,   // Line 7 MCP_SLIC2, GPB5
    };
    constexpr uint8_t RM_PINS[8] = {
      RM_04,   // Line 0 MCP_SLIC1, GPA6
      RM_15,   // Line 1 MCP_SLIC1, GPA3
      RM_26,   // Line 2 MCP_SLIC1, GPB1
      RM_37,   // Line 3 MCP_SLIC1, GPB4
      RM_04,   // Line 4 MCP_SLIC2, GPA6
      RM_15,   // Line 5 MCP_SLIC2, GPA3
      RM_26,   // Line 6 MCP_SLIC2, GPB1
      RM_37,   // Line 7 MCP_SLIC2, GPB4
    };
  }

  namespace externalGPIO {
    constexpr int EX1 = 6; // GPA6
    constexpr int EX2 = 7; // GPA7
    constexpr int EX3 = 4; // GPA4
    constexpr int EX4 = 5; // GPA5
    constexpr int EX5 = 3; // GPA3
  } 

  namespace statusLED {
    constexpr int LED_L0 = 7; // GPA7
    constexpr int LED_L1 = 6; // GPA6
    constexpr int LED_L2 = 5; // GPA5
    constexpr int LED_L3 = 4; // GPA4
    constexpr int LED_L4 = 3; // GPA3
    constexpr int LED_L5 = 2; // GPA2
    constexpr int LED_L6 = 1; // GPA1
    constexpr int LED_L7 = 0; // GPA0
  }

  namespace mt8816 {

    constexpr uint8_t ax_pins[4] = {mcp::AX0, mcp::AX1, mcp::AX2, mcp::AX3}; // GPB0-GPB3
    constexpr uint8_t ay_pins[3] = {mcp::AY0, mcp::AY1, mcp::AY2}; // GPB4-GPB6

    constexpr uint8_t  DAC1 = 15;
    constexpr uint8_t  DAC2 = 14;
    constexpr uint8_t  DAC3 = 13;
    constexpr uint8_t  D_OUTL = 12;
  }

  namespace TMUX4051 {
    constexpr uint8_t S0[3] = {0,0,0};
    constexpr uint8_t S1[3] = {0,0,1};
    constexpr uint8_t S2[3] = {0,1,0};
    constexpr uint8_t S3[3] = {0,1,1};
    constexpr uint8_t S4[3] = {1,0,0};
    constexpr uint8_t S5[3] = {1,0,1};
    constexpr uint8_t S6[3] = {1,1,0};
    constexpr uint8_t S7[3] = {1,1,1};

    constexpr const uint8_t* TMUXAddresses[8] = { S0, S1, S2, S3, S4, S5, S6, S7 };
  }
}
