ondfrukt/Phone-exchange/src/net/WifiClient.cpp

#include "WifiClient.h"
#include <time.h>
using namespace net;

WifiClient::WifiClient() : connecting_(false) {}

void WifiClient::begin(const char* hostname) {
  prefs_.begin("wifi", false);
  WiFi.persistent(false);
  WiFi.setAutoReconnect(true);
  WiFi.setSleep(false);

  // 1) Välj hostname (antingen given, eller auto baserat på MAC)
  if (hostname && strlen(hostname) > 0) {
    hostname_ = hostname;
  } else {
    hostname_ = makeDefaultHostname_(); // ex: phoneexchange-7A3F
  }

  // 2) Sätt hostname FÖRE WiFi.begin()
  if (!WiFi.setHostname(hostname_.c_str())) {
    Serial.println("WifiClient: Failed to set hostname.");
    util::UIConsole::log("Failed to set hostname.", "WifiClient");
  }

  // 3) Registrera eventlyssnare (innan connect)
  WiFi.onEvent([this](WiFiEvent_t event, WiFiEventInfo_t info){ onWiFiEvent_(event, info); });

  // 4) Försök ansluta med sparade credentials
  String savedSsid, savedPass;
  if (loadCredentials(savedSsid, savedPass)) {
    ssid_ = savedSsid;
    password_ = savedPass;
    connect_();
  } else {
    Serial.println("WifiClient: No saved credentials, waiting for provisioning...");
    util::UIConsole::log("No saved credentials, waiting for provisioning...", "WifiClient");
  }
}

void WifiClient::loop() {
  if (otaStarted_) {
    ArduinoOTA.handle();
  }

  if (provisioningActive_) {
    return;
  }

  const unsigned long now = millis();

  // If we are "connecting" for too long without a valid IP, force a reconnect.
  if (connecting_ && ((long)(now - lastConnectAttemptMs_) >= (long)kConnectAttemptTimeoutMs)) {
    Serial.println("WifiClient: Connect timeout, forcing reconnect.");
    util::UIConsole::log("Connect timeout, forcing reconnect.", "WifiClient");
    forceReconnect_();
  }

  // Automatisk reconnect med backoff så vi undviker tight loop vid fel credentials.
  const bool timeToRetry =
      (reconnectDelayMs_ == 0) ||
      ((long)(now - lastConnectAttemptMs_) >= (long)reconnectDelayMs_);
  if (!isConnected() && !connecting_ && ssid_.length() > 0 && timeToRetry) {
    connect_();
  }
}

void WifiClient::connectNow() {
  if (provisioningActive_) {
    return;
  }
  if (ssid_.length()) {
    connect_();
  }
}

void WifiClient::setProvisioningActive(bool active) {
  provisioningActive_ = active;
  if (active) {
    // Prevent the local reconnect loop from racing the provisioning manager.
    connecting_ = false;
  }
}

bool WifiClient::isConnected() const {
  if (WiFi.status() != WL_CONNECTED) {
    return false;
  }
  const IPAddress ip = WiFi.localIP();
  return ip != IPAddress((uint32_t)0);
}

String WifiClient::getIp() const {
  if (isConnected()) return WiFi.localIP().toString();
  return String("0.0.0.0");
}

String WifiClient::getMac() const {
  return WiFi.macAddress();
}

void WifiClient::saveCredentials(const char* ssid, const char* password) {
  prefs_.putString("ssid", ssid);
  prefs_.putString("pass", password);
  ssid_ = ssid;
  password_ = password;
  Serial.println("WifiClient: Credentials saved");
  util::UIConsole::log("Credentials saved", "WifiClient");
}

bool WifiClient::loadCredentials(String& ssid, String& password) {
  const bool hasSsid = prefs_.isKey("ssid");
  const bool hasPass = prefs_.isKey("pass");
  if (!hasSsid || !hasPass) {
    ssid = "";
    password = "";
    return false;
  }
  ssid = prefs_.getString("ssid", "");
  password = prefs_.getString("pass", "");
  return ssid.length() > 0;
}

void WifiClient::connect_() {
  Serial.printf("WifiClient: Connecting to %s… (host=%s)\n", ssid_.c_str(), hostname_.c_str());
  util::UIConsole::log("Connecting to " + ssid_ + "...", "WifiClient");
  WiFi.mode(WIFI_STA);
  WiFi.disconnect(false, false);
  WiFi.begin(ssid_.c_str(), password_.c_str());
  lastConnectAttemptMs_ = millis();
  if (reconnectDelayMs_ == 0) {
    reconnectDelayMs_ = kInitialReconnectDelayMs;
  }
  connecting_ = true;
}

void WifiClient::forceReconnect_() {
  connecting_ = false;
  WiFi.disconnect(false, false);
  if (reconnectDelayMs_ == 0) {
    reconnectDelayMs_ = kInitialReconnectDelayMs;
  } else {
    reconnectDelayMs_ = min(reconnectDelayMs_ * 2, kMaxReconnectDelayMs);
  }
  lastConnectAttemptMs_ = millis();
}

void WifiClient::onWiFiEvent_(WiFiEvent_t event, const WiFiEventInfo_t& info) {
  switch (event) {
    case ARDUINO_EVENT_WIFI_STA_CONNECTED:
      Serial.println("WifiClient: Connected to AP");
      util::UIConsole::log("Connected to AP", "WifiClient");
      break;

    case ARDUINO_EVENT_WIFI_STA_GOT_IP: {
      const IPAddress ip = WiFi.localIP();
      Serial.print("WifiClient: Got IP: ");
      util::UIConsole::log("Got IP: " + ip.toString(), "WifiClient");
      Serial.println(ip);
      connecting_ = false;
      reconnectDelayMs_ = 0;

      if (ip == IPAddress((uint32_t)0)) {
        Serial.println("WifiClient: Got IP event but local IP is still 0.0.0.0, waiting...");
        util::UIConsole::log("Got IP event but local IP is 0.0.0.0, waiting...", "WifiClient");
        break;
      }

      // Synkronisera klockan med NTP
      syncTime_();

      // Starta mDNS när IP är klart
      if (!mdnsStarted_) {
        if (MDNS.begin(hostname_.c_str())) {
          mdnsStarted_ = true;
          MDNS.addService("http", "tcp", 80);
          Serial.printf("WifiClient: mDNS igång → http://%s.local/\n", hostname_.c_str());
          util::UIConsole::log("mDNS running → http://" + hostname_ + ".local/", "WifiClient");
        } else {
          Serial.println("WifiClient: ⚠️ MDNS.begin misslyckades");
          util::UIConsole::log("⚠️ MDNS.begin failed", "WifiClient");
        }
      }

      // Starta OTA-uppdateringstjänsten (endast en gång)
      if (!otaStarted_) {
        startOta_();
      }
      break;
    }

    case ARDUINO_EVENT_WIFI_STA_DISCONNECTED:
      connecting_ = false;
      if (reconnectDelayMs_ == 0) {
        reconnectDelayMs_ = kInitialReconnectDelayMs;
      } else {
        reconnectDelayMs_ = min(reconnectDelayMs_ * 2, kMaxReconnectDelayMs);
      }
      Serial.printf("WifiClient: Disconnected (reason=%d), will retry in %lu ms.\n",
                    info.wifi_sta_disconnected.reason,
                    reconnectDelayMs_);
      util::UIConsole::log("Disconnected, retry with backoff...", "WifiClient");
      // Stäng mDNS tills vi åter har IP
      if (mdnsStarted_) {
        MDNS.end();
        mdnsStarted_ = false;
      }
      break;

    case ARDUINO_EVENT_WIFI_STA_LOST_IP:
      Serial.println("WifiClient: Lost IP, forcing reconnect.");
      util::UIConsole::log("Lost IP, forcing reconnect.", "WifiClient");
      forceReconnect_();
      break;

    default:
      break;
  }
}

void WifiClient::startOta_() {
  // mDNS annonseras redan av oss (se ovan), så låt inte ArduinoOTA starta en egen instans.
  ArduinoOTA.setMdnsEnabled(false);
  ArduinoOTA.setHostname(hostname_.c_str());

  ArduinoOTA.onStart([]() {
    const char* type = (ArduinoOTA.getCommand() == U_FLASH) ? "firmware" : "filesystem";
    Serial.printf("WifiClient: OTA update starting (%s)\n", type);
    util::UIConsole::log(String("OTA update starting (") + type + ")", "WifiClient");
  });

  ArduinoOTA.onEnd([]() {
    Serial.println("WifiClient: OTA update complete, restarting...");
    util::UIConsole::log("OTA update complete, restarting...", "WifiClient");
  });

  ArduinoOTA.onProgress([](unsigned int progress, unsigned int total) {
    static unsigned int lastPct = 101;
    const unsigned int pct = total ? (progress * 100) / total : 0;
    if (pct != lastPct) {
      lastPct = pct;
      Serial.printf("WifiClient: OTA progress: %u%%\n", pct);
    }
  });

  ArduinoOTA.onError([](ota_error_t error) {
    Serial.printf("WifiClient: OTA error [%u]\n", static_cast<unsigned int>(error));
    util::UIConsole::log("OTA error: " + String(static_cast<int>(error)), "WifiClient");
  });

  ArduinoOTA.begin();
  otaStarted_ = true;

  // Annonsera OTA-tjänsten manuellt eftersom mDNS drivs av oss (se ovan).
  MDNS.addService("arduino", "tcp", 3232);

  Serial.printf("WifiClient: OTA update service ready on port 3232 (host=%s)\n", hostname_.c_str());
  util::UIConsole::log("OTA update service ready on port 3232", "WifiClient");
}

String WifiClient::makeDefaultHostname_() {
  uint8_t mac[6];
  WiFi.macAddress(mac);
  char buf[32];
  snprintf(buf, sizeof(buf), "phoneexchange-%02X%02X", mac[4], mac[5]);
  return String(buf);
}

void WifiClient::syncTime_() {
  // Konfigurera tidszon för svensk tid (CET/CEST med automatisk sommartid)
  // CET-1CEST,M3.5.0,M10.5.0/3 = CET är UTC+1, CEST börjar sista söndagen i mars, slutar sista söndagen i oktober
  configTime(0, 0, "pool.ntp.org", "time.nist.gov");
  setenv("TZ", "CET-1CEST,M3.5.0,M10.5.0/3", 1);
  tzset();
  
  Serial.println("WifiClient: Syncing time with NTP...");
  util::UIConsole::log("Syncing time with NTP...", "WifiClient");
  
  // Vänta lite för att NTP ska hinna synka
  struct tm timeinfo;
  int retries = 0;
  while (!getLocalTime(&timeinfo) && retries < 10) {
    delay(500);
    retries++;
  }
  
  if (retries < 10) {
    char timeStr[64];
    strftime(timeStr, sizeof(timeStr), "%Y-%m-%d %H:%M:%S", &timeinfo);
    Serial.printf("WifiClient: Time synced: %s\n", timeStr);
    util::UIConsole::log("Time synced: " + String(timeStr), "WifiClient");
  } else {
    Serial.println("WifiClient: Failed to sync time");
    util::UIConsole::log("Failed to sync time", "WifiClient");
  }
}
