ondfrukt/Phone-exchange/src/net/Provisioning.cpp

#include "Provisioning.h"
#include <esp_err.h>
using namespace net;

// Justera vid behov
static const char* kPop         = "abcd1234";         // Proof of Possession (PIN)
static const char* kServiceName = "PHONE_EXCHANGE";   // Namn som syns i Espressifs app
static const char* kServiceKey  = nullptr;            // Används bara för SoftAP
static const bool  kResetProv   = true;               // Rensa tidigare provisioning-state när SoftAP-provisioning startar

void Provisioning::begin(WifiClient& wifiClient, const char* hostname) {
  host_ = hostname;
  wifi_ = &wifiClient;
  pendingSsid_.clear();
  pendingPassword_.clear();
  credentialsCommitted_ = false;
  resetStatePending_ = false;
  credFailAtMs_ = 0;
  provisioningStartedAtMs_ = 0;
  provisioningEndedAtMs_ = 0;
  postProvisioningCleanupPending_ = false;
  startedProvisioning_ = false;

  // Lyssna på systemhändelser (Wi-Fi + provisioning)
  WiFi.onEvent(&Provisioning::onSysEvent_);

  // Om WifiClient redan har creds -> starta inte provisioning.
  if (wifi_->hasCredentials()) {
    wifi_->setProvisioningActive(false);
    Serial.println("Provisioning: Saved SSID found. Skipping provisioning.");
    util::UIConsole::log("Saved SSID found. Skipping provisioning.", "Provisioning");
    return;
  }

  // Annars startar vi SoftAP-provisioning så användaren kan mata in creds
  startedProvisioning_ = true;
  provisioningStartedAtMs_ = millis();
  wifi_->setProvisioningActive(true);

  Serial.println("Provisioning: Start SoftAP provisioning.");
  util::UIConsole::log("Start SoftAP provisioning.", "Provisioning");
  WiFiProv.beginProvision(
    WIFI_PROV_SCHEME_SOFTAP,              // Transport: SoftAP
    WIFI_PROV_SCHEME_HANDLER_NONE,        // No extra transport handler for SoftAP
    WIFI_PROV_SECURITY_1,                 // PoP/PIN-säkerhet
    kPop,                                 // PoP
    kServiceName,                         // SoftAP SSID
    kServiceKey,                          // SoftAP password if set, otherwise open
    nullptr,                              // UUID not used in SoftAP provisioning
    kResetProv
  );
}

void Provisioning::loop() {
  if (postProvisioningCleanupPending_ && provisioningEndedAtMs_ != 0 &&
      (millis() - provisioningEndedAtMs_ >= 250)) {
    wifi_prov_mgr_stop_provisioning();
    wifi_prov_mgr_deinit();
    WiFi.softAPdisconnect(true);
    WiFi.mode(WIFI_STA);
    postProvisioningCleanupPending_ = false;
  }

  if (!startedProvisioning_) {
    return;
  }

  if (resetStatePending_ && (millis() - credFailAtMs_ >= kResetStateDelayMs)) {
    const esp_err_t err = wifi_prov_mgr_reset_sm_state_on_failure();
    if (err == ESP_OK) {
      Serial.println("Provisioning: Reset to waiting state after credential failure.");
      util::UIConsole::log("Reset to waiting state after credential failure.", "Provisioning");
      resetStatePending_ = false;
    } else {
      Serial.printf("Provisioning: reset_sm_state_on_failure failed (%d), retrying...\n", static_cast<int>(err));
      util::UIConsole::log("reset_sm_state_on_failure failed, retrying...", "Provisioning");
      credFailAtMs_ = millis();
    }
  }

  const unsigned long elapsed = millis() - provisioningStartedAtMs_;
  if (elapsed >= kProvisioningWindowMs) {
    Serial.println("Provisioning: 5-minute provisioning window expired, stopping provisioning.");
    util::UIConsole::log("5-minute provisioning window expired, stopping provisioning.", "Provisioning");
    stopProvisioning_();
  }
}

void Provisioning::stopProvisioning_() {
  if (!startedProvisioning_) {
    return;
  }

  startedProvisioning_ = false;
  provisioningEndedAtMs_ = millis();
  postProvisioningCleanupPending_ = true;
  if (wifi_) {
    wifi_->setProvisioningActive(false);
  }
  pendingSsid_.clear();
  pendingPassword_.clear();
  credentialsCommitted_ = false;
  resetStatePending_ = false;
}

void Provisioning::factoryReset() {
  Serial.println("Provisioning: Factory reset: erasing Wi-Fi creds (NVS) and restarting...");
  util::UIConsole::log("Factory reset: erasing Wi-Fi creds (NVS) and restarting...", "Provisioning");
  
  // Rensa WifiClient credentials (Preferences)
  Preferences prefs;
  prefs.begin("wifi", false);
  prefs.clear();  // Radera alla nycklar i "wifi" namnutrymmet
  prefs.end();
  
  // Rensa WiFi-credentials från NVS
  WiFi.disconnect(true /*wifioff*/, true /*erase NVS*/);
  
  delay(250);
  ESP.restart();
}

void Provisioning::onSysEvent_(arduino_event_t *sys_event) {
  switch (sys_event->event_id) {
    case ARDUINO_EVENT_PROV_START:
      if (wifi_) {
        wifi_->setProvisioningActive(true);
      }
      Serial.println("Provisioning: Provisioning started (SoftAP mode).");
      util::UIConsole::log("Provisioning started (SoftAP mode).", "Provisioning");
      break;

    case ARDUINO_EVENT_PROV_CRED_RECV: {
      const char* ssid = (const char*)sys_event->event_info.prov_cred_recv.ssid;
      const char* pwd  = (const char*)sys_event->event_info.prov_cred_recv.password;
      Serial.printf("Provisioning: Received Wi-Fi creds. SSID=\"%s\"\n", ssid);
      util::UIConsole::log("Received Wi-Fi creds. SSID=\"" + String(ssid) + "\"", "Provisioning");
      pendingSsid_ = ssid ? ssid : "";
      pendingPassword_ = pwd ? pwd : "";
      credentialsCommitted_ = false;
      break;
    }

    case ARDUINO_EVENT_PROV_CRED_SUCCESS:
      Serial.println("Provisioning: Credentials accepted.");
      util::UIConsole::log("Credentials accepted.", "Provisioning");
      if (wifi_ && pendingSsid_.length() > 0 && !credentialsCommitted_) {
        wifi_->saveCredentials(pendingSsid_.c_str(), pendingPassword_.c_str());
        credentialsCommitted_ = true;
      }
      break;

    case ARDUINO_EVENT_PROV_CRED_FAIL:
      Serial.println("Provisioning: Credentials failed (wrong password or AP not found).");
      util::UIConsole::log("Credentials failed (wrong password or AP not found).", "Provisioning");
      pendingSsid_.clear();
      pendingPassword_.clear();
      credentialsCommitted_ = false;
      resetStatePending_ = true;
      credFailAtMs_ = millis();
      break;

    case ARDUINO_EVENT_PROV_END:
      Serial.println("Provisioning: Provisioning finished.");
      util::UIConsole::log("Provisioning finished.", "Provisioning");
      startedProvisioning_ = false;
      provisioningEndedAtMs_ = millis();
      postProvisioningCleanupPending_ = true;
      if (wifi_) {
        wifi_->setProvisioningActive(false);
      }
      pendingSsid_.clear();
      pendingPassword_.clear();
      credentialsCommitted_ = false;
      resetStatePending_ = false;
      break;

    // Rena Wi-Fi-händelser (för logg)
    //case ARDUINO_EVENT_WIFI_STA_CONNECTED:
    //  Serial.println("[WIFI] Connected to AP.");
    //  break;

    //case ARDUINO_EVENT_WIFI_STA_GOT_IP:
    //  Serial.printf("[WIFI] Got IP: %s\n", WiFi.localIP().toString().c_str());
    //  break;

    // case ARDUINO_EVENT_WIFI_STA_DISCONNECTED:
    //   Serial.println("[WIFI] Disconnected.");
    //   break;

    default:
      break;
  }
}
