ondfrukt/Phone-exchange/src/services/LineManager.h

#pragma once
#include <functional>
#include <vector>
#include "settings/settings.h"
#include "model/Types.h"
#include "util/UIConsole.h"
#include "LineHandler.h"

class ToneReader;

class LineManager {
public:
  LineManager(Settings& settings);
  void begin();
  void setToneReader(ToneReader* toneReader) { toneReader_ = toneReader; };
  void syncLineActive(size_t i);
  void setStatus(int index, LineStatus newStatus);
  void clearChangeFlag(int index);
  void setLineTimer(int index, unsigned int limit);
  void resetLineTimer(int index);
  void setPhoneNumber(int index, const String& value);
  void setLineName(int index, const String& value);
  int searchPhoneNumber(const String& phoneNumber);

  using StatusChangedCallback = std::function<void(int /*lineIndex*/, model::LineStatus)>;
  using ActiveLinesChangedCallback = std::function<void(uint8_t)>;

  // Callback functions for webserver
  void setStatusChangedCallback(StatusChangedCallback cb);
  void addStatusChangedCallback(StatusChangedCallback cb);
  void setActiveLinesChangedCallback(ActiveLinesChangedCallback cb);

  LineHandler& getLine(int index);

  uint8_t lineStatusChangeFlag; // Bitmask for lines with status changes
  uint8_t lineHookChangeFlag;   // Bitmask for lines with hook status changes
  uint8_t activeTimersMask;     // Bitmask for active line timers
  uint8_t linesNotIdle;         // Bitmask for lines that are not Idle
  uint8_t toneScanMask;         // Bitmask for lines that should be scanned for tones

  int lastLineReady;   // Most recent line that became Ready (for toneReader)

private:
  void syncFromSettings_();

  // The vector that holds all LineHandler instances
  std::vector<LineHandler> lines;
  
  Settings& settings_;
  ToneReader* toneReader_ = nullptr;
  std::vector<StatusChangedCallback> statusChangedCallbacks_;

};
