ondfrukt/Phone-exchange/src/net/WifiClient.h

#pragma once
#include <WiFi.h>
#include <ESPmDNS.h>
#include <ArduinoOTA.h>
#include <Preferences.h>
#include "util/UIConsole.h"

namespace net {

class WifiClient {
public:
    WifiClient();

    // Initiera med app-namn, används för mDNS/OTA
    void begin(const char* hostname = "phoneexchange");

    // Körs i din App::loop()
    void loop();

    // Status
    bool isConnected() const;
    String getIp() const;
    String getHostname() const { return hostname_; }
    String getMac() const;

    // Hantering av credentials (kan sättas av provisioning)
    void saveCredentials(const char* ssid, const char* password);
    bool loadCredentials(String& ssid, String& password);

    bool hasCredentials() const { return ssid_.length() > 0; }
    void connectNow();
    void setProvisioningActive(bool active);
    bool isProvisioningActive() const { return provisioningActive_; }

private:
    void connect_();
    void forceReconnect_();
    void onWiFiEvent_(WiFiEvent_t event, const WiFiEventInfo_t& info);
    String makeDefaultHostname_();
    void syncTime_();
    void startOta_();

    Preferences prefs_;
    String ssid_;
    String password_;
    String hostname_;
    bool connecting_;
    bool provisioningActive_ = false;
    bool mdnsStarted_ = false;
    bool otaStarted_ = false;
    unsigned long lastConnectAttemptMs_ = 0;
    unsigned long reconnectDelayMs_ = 0;
    static constexpr unsigned long kInitialReconnectDelayMs = 5000;
    static constexpr unsigned long kMaxReconnectDelayMs = 60000;
    static constexpr unsigned long kConnectAttemptTimeoutMs = 20000;
};

} // namespace net
