ondfrukt/Phone-exchange/src/net/WebServer.h

#pragma once
#include <Arduino.h>
#include <ESPAsyncWebServer.h>
#include <LittleFS.h>
#include "net/WifiClient.h"
#include "net/Provisioning.h"
#include "settings/settings.h"
#include "services/LineAction.h"

namespace net {
  class WifiClient;
  class MqttClient;
}

class LineManager;
class RingGenerator;

class WebServer {
public:
  WebServer(Settings& settings, LineManager& lineManager, net::WifiClient& wifi, net::MqttClient& mqtt, RingGenerator& ringGenerator, LineAction& lineAction, uint16_t port = 80);
  bool begin();
  void update();
  void listFS();

  bool isReady() const { return serverStarted_ && fsMounted_; }

  // Publika hjälpmetoder om du vill kunna pusha manuellt
  void sendFullStatusSse();
  void sendActiveMaskSse();
  void sendDebugSse();
  void sendToneGeneratorSse();

private:
  Settings& settings_;
  LineManager& lineManager_;
  RingGenerator& ringGenerator_;
  LineAction& lineAction_;
  AsyncWebServer server_;
  AsyncEventSource events_{"/events"};
  
  net::WifiClient& wifi_;
  net::MqttClient& mqtt_;


  bool serverStarted_ = false;
  bool fsMounted_ = false;

  TaskHandle_t pingTask_ = nullptr;
  
  void setupFilesystem_();
  void initSse_();
  void setupCallbacks_();
  void setupLineManagerCallback_();
  void setupApiRoutes_();
  void setLineActiveBit_(int line, bool makeActive);
  void restartDevice_();
  void toggleLineActiveBit_(int line);

  void pushInitialSnapshot_();

  void startPingLoop_();

  // Help functions
  String buildStatusJson_() const;
  String buildActiveJson_(uint8_t mask);
  String buildDebugJson_() const;
  String buildToneGeneratorJson_() const;
  String buildMqttJson_() const;

  // Bind the util::Console sink to forward JSON messages to SSE "console"
  void bindConsoleSink_();
};
