ondfrukt/Phone-exchange/(commit log)

2025-08-17 new file: data/app.js new file: data/index.html new file: data/style.css new file: include/JsonProcessor.h new file: include/LineAction.h new file: include/LineHandler.h new file: include/LineManager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
2025-08-19 modified: include/MCPDriver.h modified: include/MCPInterruptService.h modified: include/config.h modified: platformio.ini modified: src/app/App.cpp modified: src/app/App.h modified: src/drivers/MCPDr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
2025-08-21 modified: include/LineHandler.h modified: include/MCPDriver.h new file: include/Readme.md modified: include/config.h new file: include/settings.h modified: src/drivers/MCPDriver.cpp
2025-08-23 modified: include/LineHandler.h modified: include/LineManager.h modified: include/Readme.md modified: include/settings.h modified: src/drivers/MCPDriver.cpp modified: src/net/WebServer.cpp modified: 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
2025-08-23 modified: include/MCPDriver.h modified: include/config.h modified: src/app/App.cpp modified: src/drivers/MCPDriver.cpp
2025-08-24 modified: include/LineAction.h modified: include/MCPDriver.h modified: include/config.h modified: platformio.ini modified: src/app/App.cpp modified: src/app/App.h modified: src/drivers/MCPDriver.cpp 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
2025-08-28 deleted: include/LineManager.h modified: include/config.h deleted: include/settings.h deleted: include/settings_global.h modified: platformio.ini new file: src/PhoneExchange.zip modified: src/app/App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
2025-08-30 modified: Phome exchange.drawio deleted: src/PhoneExchange.zip modified: src/drivers/MCPDriver.cpp modified: src/drivers/MCPDriver.h
2025-08-30 modified: include/config.h modified: src/app/App.cpp modified: src/drivers/MCPDriver.cpp modified: src/net/WebServer.cpp modified: src/services/SHKService.cpp
2025-08-30 modified: Phome exchange.drawio modified: src/app/App.cpp modified: src/app/App.h modified: src/drivers/MCPDriver.cpp modified: src/drivers/MCPDriver.h modified: src/services/SHKService.cpp modified: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
2025-08-31 modified: src/drivers/MCPDriver.cpp modified: src/services/SHKService.cpp modified: src/settings/Settings.cpp modified: src/settings/settings.h
2025-09-10 Document SHK Service functionality in Readme.md
    Added documentation for SHK (Hook) Service, detailing its responsibilities and typical trigger chain.
2025-09-11 Enhance README with status table and flow chart
2025-09-13 new file: docs/MT8816 Connections.png modified: src/app/App.cpp modified: src/drivers/MCPDriver.cpp new file: src/drivers/MT8816 matrix.md modified: src/drivers/Readme.md modified: src/services/LineA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
2025-09-15 modified: include/config.h modified: platformio.ini modified: src/app/App.cpp modified: src/app/App.h modified: src/drivers/MCPDriver.cpp modified: src/drivers/MCPDriver.h modified: src/main.cpp
2025-09-16 modified: data/app.js modified: data/index.html modified: data/style.css modified: platformio.ini modified: src/app/App.cpp modified: src/app/App.h modified: src/drivers/MCPDriver.cpp modified: src/n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
2025-09-17 modified: data/app.js modified: data/index.html modified: include/config.h modified: src/app/App.cpp modified: src/app/App.h modified: src/drivers/MT8816Driver.cpp new file: src/drivers/MT8816Driver.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
2025-09-18 modified: include/config.h modified: src/app/App.cpp modified: src/app/App.h modified: src/drivers/MCPDriver.cpp modified: src/drivers/MCPDriver.h modified: src/drivers/MT8816Driver.cpp modified: src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
2025-09-22 modified: include/config.h modified: src/app/App.cpp modified: src/drivers/MCPDriver.cpp modified: src/drivers/MT8816Driver.cpp modified: src/services/LineAction.cpp modified: src/services/SHKService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
2025-10-19 modified: data/app.js modified: data/index.html modified: data/style.css modified: include/config.h deleted: lib/README modified: src/app/App.cpp modified: src/app/App.h modified: src/drivers/MCPDriv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
2025-10-22 modified: src/app/App.cpp modified: src/drivers/MCPDriver.cpp modified: src/drivers/MCPDriver.h modified: src/drivers/MT8816Driver.cpp modified: src/net/Provisioning.cpp modified: src/net/Provisionin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
2025-10-22 modified: include/config.h modified: src/app/App.cpp modified: src/app/App.h modified: src/drivers/MCPDriver.cpp modified: src/main.cpp modified: src/services/SHKService.cpp modified: src/util/Functi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
2025-10-22 modified: data/app.js modified: src/app/App.cpp modified: src/drivers/MCPDriver.cpp modified: src/services/SHKService.cpp
2025-11-09 Prevent duplicate phone numbers per line
    [LineHandler.cpp, LineManager.cpp, LineManager.h, Settings.cpp, StatusSerializer.cpp, WebServer.cpp]
2025-11-09 Fix async param lookup helper
    [LineHandler.cpp, LineManager.cpp, LineManager.h, Settings.cpp, StatusSerializer.cpp, WebServer.cpp]
2025-11-11 modified: src/drivers/MCPDriver.cpp modified: src/drivers/MCPDriver.h modified: src/settings/Settings.cpp
2025-12-05 modified: src/drivers/MCPDriver.cpp modified: src/services/ToneReader.cpp modified: src/app/App.cpp modified: src/settings/settings.h
2025-12-07 Add DTMF debouncing to prevent multiple triggers
    [ToneReader.cpp, ToneReader.h]
2025-12-07 Address code review feedback: fix magic number and millis rollover
    [ToneReader.cpp, ToneReader.h]
2025-12-07 Fix DTMF debug messages appearing for non-DTMF interrupts
    [ToneReader.cpp]
2025-12-07 Fix code review issues: uninitialized variable usage and improve debug messages
    [MCPDriver.cpp, ToneReader.cpp]
2025-12-07 Final code review fixes: optimize performance and fix documentation consistency
    [MCPDriver.cpp, ToneReader.cpp]
2025-12-07 modified: README.md new file: docs/DTMF_DEBUGGING.md new file: "docs/DTMF_FELS\303\226KNING_SNABBGUIDE.md" modified: src/app/App.cpp modified: src/drivers/MCPDriver.cpp modified: src/drivers/MCPDrive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
2025-12-07 Reset tone reader state when debug level changes
    [ToneReader.cpp]
2025-12-08 Update README with flowchart attribution
    Added attribution to GadgetReboot for flowchart inspiration.
2025-12-08 modified: data/style.css modified: src/drivers/MCPDriver.cpp
2025-12-09 Fix FR/RM pin mappings and prevent ghost tone detection
    [LineManager.cpp, ToneReader.cpp, config.h]
2025-12-11 new file: BugsToFix.txt deleted: _codeql_detected_source_root modified: src/net/WebServer.h modified: src/services/RingGenerator.cpp modified: src/services/SHKService.cpp
    [RingGenerator.cpp, SHKService.cpp, WebServer.h]
2025-12-11 Replace magic number 8 with cfg::mcp::SHK_LINE_COUNT constant
    [RingGenerator.cpp, RingGenerator.h]
2025-12-11 Fix formatting: remove extra space in RingState enum
    [RingGenerator.h]
2025-12-11 Refactor RingGenerator to use LineManager bitmask and LineHandler state
    - Add linesRinging bitmask to LineManager for tracking active rings
    - Move ring timing state from RingGenerator to LineHandler
    - Change ring stop condition from status change to hook status check
    - This prevents spurious status changes from interrupting ringing
    [LineHandler.cpp, LineHandler.h, LineManager.cpp, LineManager.h, RingGenerator.cpp, RingGenerator.h]
2025-12-11 Address code review feedback
    - Improve comment clarity for getRingState() method
    - Update helper method comments in header
    - Fix typo: Intiate -> Initiate
    [LineManager.cpp, RingGenerator.cpp, RingGenerator.h]
2025-12-11 Revert "Fix RingGenerator spurious interruption and refactor state to LineManager/LineHandler"
    [LineHandler.cpp, LineHandler.h, LineManager.cpp, LineManager.h, RingGenerator.cpp, RingGenerator.h]
2025-12-13 new file: BugsToFix.md deleted: BugsToFix.txt new file: docs/MCPInterrupts.drawio modified: src/services/SHKService.cpp
    [SHKService.cpp]
2025-12-13 Implement InterruptManager and refactor components to use it
2025-12-13 Fix SHKService header to include MCPDriver
    [SHKService.h]
2025-12-13 modified: src/drivers/InterruptManager.cpp modified: src/drivers/MCPDriver.cpp modified: src/settings/Settings.cpp
2025-12-13 modified: src/drivers/MCPDriver.cpp
2025-12-13 modified: BugsToFix.md modified: src/app/App.cpp modified: src/drivers/InterruptManager.cpp modified: src/services/LineAction.cpp modified: src/services/LineAction.h modified: src/services/LineManage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
    [App.cpp, InterruptManager.cpp, LineAction.cpp, LineAction.h, LineManager.cpp, RingGenerator.cpp, RingGenerator.h, Settings.cpp]
2025-12-13 modified: BugsToFix.md modified: platformio.ini modified: src/drivers/MCPDriver.cpp modified: src/services/LineManager.cpp modified: src/services/SHKService.cpp modified: src/services/SHKService.h mo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
    [LineManager.cpp, MCPDriver.cpp, SHKService.cpp, SHKService.h, Settings.cpp]
2025-12-13 modified: platformio.ini modified: src/app/App.cpp modified: src/app/App.h modified: src/drivers/InterruptManager.cpp modified: src/drivers/InterruptManager.h modified: src/model/Types.h modified: sr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
2025-12-13 Use ring-aware hook stability duration
    [SHKService.cpp, SHKService.h]
2025-12-14 Fix LineManager and ToneReader initialization dependencies
    [App.cpp, App.h, LineManager.h, ToneReader.cpp, ToneReader.h]
2025-12-14 Revert "Fix LineManager and ToneReader initialization dependencies"
    [App.cpp, App.h, LineManager.h, ToneReader.cpp, ToneReader.h]
2025-12-14 Fix all three bugs: NVS key length, SSE queue overflow, and debug settings crash
    [Settings.cpp, WebServer.cpp]
2025-12-14 Remove leftover debug print statement
2025-12-27 Fix infinite recursion bug in WebServer debug logging
    [WebServer.cpp]
2025-12-29 modified: BugsToFix.md modified: include/config.h modified: platformio.ini modified: src/services/LineAction.cpp modified: src/services/LineManager.cpp modified: src/services/SHKService.cpp modified: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
    [LineAction.cpp, LineManager.cpp, SHKService.cpp, SHKService.h, Settings.cpp, config.h]
2025-12-29 Add configurable DTMF tolerances and improved signal filtering to ToneReader
    [Settings.cpp, ToneReader.cpp, ToneReader.h]
2025-12-29 Fix tone duration validation to properly reject short tones
    [ToneReader.cpp]
2025-12-29 Fix pulse dialing interrupted by hook filter detecting OnHook during pulses
    [SHKService.cpp]
2025-12-29 Revert "Fix hook filter interrupting pulse dialing by treating pulses as hook state changes"
    [SHKService.cpp]
2025-12-29 Fix SHK hook filter confusion during pulse dialing
    Prevent hook filter from declaring OnHook state during active pulse dialing.
    The hook filter now skips state updates when pdState is not Idle, avoiding
    confusion between pulse low states and actual OnHook transitions.
    [SHKService.cpp]
2025-12-29 Fix hook detection to allow hanging up during pulse dialing
    Modified SHKService.cpp to allow OnHook (hanging up) detection even when
    pulse detector is active. Previously, all hook state changes were blocked
    during pulse dialing, preventing the phone from being hung up after dialing
    some digits. Now only OffHook transitions are blocked to prevent confusion
    with pulse low states, while OnHook transitions are always allowed.
    [SHKService.cpp]
2025-12-29 Use timing-based approach to distinguish pulses from hook changes
    Instead of blocking hook changes during pulse dialing, now use a longer
    stability time requirement (pulseLowMaxMs + 50ms = 200ms) when the pulse
    detector is active. This ensures that:
    - Short pulses (25-150ms) are not mistaken for hook changes
    - Actual hook changes (hanging up) are still detected after sufficient stability
    - Both hanging up and picking up work correctly during pulse dialing
    This approach is cleaner and more reliable than blocking specific transitions.
    [SHKService.cpp]
2025-12-29 Replace magic number with named constant for pulse margin
    Introduced kPulseMarginMs constant to improve code maintainability and
    make the timing relationship explicit.
    [SHKService.cpp]
2026-01-01 Add Serial.flush() calls to fix pulse dialing serial output buffering issue
    [SHKService.cpp]
2026-01-03 modified: BugsToFix.md new file: src/services/ConnectionMatrix.cpp new file: src/services/ConnectionMatrix.h modified: src/services/LineAction.cpp modified: src/services/LineAction.h modified: src/se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
    [LineAction.cpp, LineAction.h, LineManager.cpp, LineManager.h, SHKService.cpp, Settings.cpp, ToneReader.cpp]
2026-01-04 modified: BugsToFix.md new file: data/button-demo.html modified: data/style.css new file: docs/Button_System_Guide.md
2026-01-04 Fix webserver issues: SSE overflow, KEY_TOO_LONG errors, move console to debug page, add missing debug levels
    [Settings.cpp, WebServer.cpp]
2026-01-04 modified: platformio.ini modified: src/app/App.h modified: src/drivers/MCPDriver.cpp modified: src/net/WebServer.cpp modified: src/services/LineHandler.h deleted: src/util/FlashLED.cpp deleted: src/u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
2026-01-05 modified: BugsToFix.md modified: data/settings.html modified: data/settings.js modified: data/style.css modified: src/net/WebServer.cpp modified: src/net/WifiClient.cpp modified: src/net/WifiClient.h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
    [UIConsole.cpp, WebServer.cpp, WifiClient.cpp, WifiClient.h]
2026-01-06 modified: BugsToFix.md modified: include/config.h modified: src/net/Provisioning.cpp modified: src/net/Provisioning.h modified: src/net/WebServer.cpp modified: src/net/WebServer.h modified: src/servi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
    [Functions.cpp, Functions.h, LineManager.cpp, Provisioning.cpp, Provisioning.h, WebServer.cpp, WebServer.h, config.h]
2026-02-07 modified: include/config.h modified: src/app/App.cpp modified: src/drivers/MCPDriver.cpp modified: src/services/LineAction.cpp modified: src/util/Functions.cpp
2026-02-07 Clarify and harden SLIC SHK interrupt-on-change configuration
2026-02-07 Throttle GPIOTest reads to avoid instantly clearing MCP INT
    [App.cpp, MCPDriver.cpp]
2026-02-07 modified: include/config.h modified: src/app/App.cpp modified: src/drivers/MCPDriver.cpp modified: src/settings/Settings.cpp
2026-02-08 modified: include/config.h modified: src/app/App.cpp modified: src/app/App.h new file: src/drivers/DTMF_Mux.cpp new file: src/drivers/DTMF_Mux.h modified: src/drivers/MCPDriver.cpp modified: src/driv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
2026-02-08 deleted: src/drivers/MT8816 matrix new.md deleted: src/drivers/MT8816 matrix old.md modified: src/drivers/MT8816Driver.cpp modified: src/drivers/MT8816Driver.h deleted: src/services/ConnectionMatrix.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
2026-02-08 modified: src/app/App.cpp modified: src/drivers/MCPDriver.cpp
2026-02-11 modified: include/config.h modified: src/app/App.cpp modified: src/app/App.h modified: src/drivers/MCPDriver.cpp modified: src/drivers/MT8816Driver.cpp modified: src/model/Types.h modified: src/net/W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
2026-02-13 modified: include/config.h modified: src/drivers/MCPDriver.cpp modified: src/drivers/MCPDriver.h modified: src/services/LineHandler.cpp modified: src/services/LineHandler.h modified: src/services/Lin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
2026-02-14 Set up call connections via MT8817 Fixes #72
    [App.cpp, Provisioning.cpp, Provisioning.h, WifiClient.cpp, WifiClient.h]
2026-02-15 new file: data/audio/not_connected_to_grid_16kHz.wav new file: data/audio/not_connected_to_grid_48kHz.wav new file: src/drivers/PCMDriver.cpp new file: src/drivers/PCMDriver.h new file: src/services/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
2026-02-15 deleted: BugsToFix.md modified: data/app.js modified: data/style.css modified: platformio.ini modified: src/app/App.cpp modified: src/net/WebServer.cpp modified: src/services/LineHandler.cpp modified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
    [App.cpp, LineHandler.cpp, LineHandler.h, LineManager.cpp, LineManager.h, Settings.cpp, StatusSerializer.cpp, WebServer.cpp]
2026-02-15 deleted: src/drivers/Readme.md deleted: src/net/Readme.md
2026-02-15 modified: data/settings.html modified: data/settings.js modified: src/app/App.cpp modified: src/app/App.h new file: src/drivers/AD9833Driver.cpp new file: src/drivers/AD9833Driver.h modified: src/dri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
2026-10-24 modified: .gitignore modified: .vscode/extensions.json new file: KiCad/Exchange ESP-unit S3 V1.4/Exchange ESP-unit S3.kicad_pcb new file: KiCad/Exchange ESP-unit S3 V1.4/Exchange ESP-unit S3.kicad_pr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
2026-10-24 Add KiCad/ELEKTRONIK.md electronics documentation (#98)
    Documents ESP-unit V1.4 and SLIC-unit V1.3 from the KiCad schematics:
    power, buses, MCP23017 tables, MT8816 matrix, tones, DTMF, SLIC per
    line, solder jumpers and known schematic deviations. CLAUDE.md points
    to it.
2026-10-24 modified: KiCad/Exchange ESP-unit S3 V1.4/Exchange ESP-unit S3.kicad_sch new file: docs/datasheets/AD9833SRMZ-EP-RL7.PDF new file: docs/datasheets/ESP32-S3-WROOM-1.PDF new file: docs/datasheets/KS083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
2026-10-24 Verify ELEKTRONIK.md against datasheets in docs/datasheets (#100)
    Check component-behaviour claims against datasheets and mark them
    'Enligt datablad' with file and page. Findings: CPGND (U10 pin 3) not
    on GND, Y1 value typo (3.579545 MHz), MCP INT levels and INTA/INTB
    tie rules, analog signal range on MT8816/TMUX4051, KS0835F supply and
    TVS observations. Add section 14 listing datasheets used.
2026-10-24 new file: KiCad/Exchange SLIC-unit V1.3/#auto_saved_files#
2026-10-24 Fix misleading docs and remove dead files (#103)
    - Correct HookStatus On/Off comments in Types.h
    - Fix factual errors in src/services/Readme.md
    - Point MT8816 link in README.md to KiCad/ELEKTRONIK.md
    - Remove empty/unused version.h and OTAUpdater, and uninformative app/util READMEs
    - Rename i2CScanner.h -> I2CScanner.h (case-sensitive filesystems)
